Appletea404/Solar_Master_Slave/README.md

# ☀️ HELIOS-BMS

## **1. Project Summary (프로젝트 요약)**

**광원 추적형 태양광 충전 및 다중 센서 안전 제어를 통합한 차세대 EV 플랫폼**

자동차 산업의 전동화 및 SDV(Software Defined Vehicle) 전환 흐름에 대응하여, **태양광 에너지 수집, 고효율 충전 시스템, 배터리 안전 관리, 차량 주행 제어** 기능을 단일 MCU 플랫폼으로 제작

## 2. Key Features (주요 기능)

### 🔋 Buck Converter 기반 태양광 충전 시스템

- **Buck Converter 기반 전용 충전 모듈** 설계로 태양광 전력을 배터리 충전 전압으로 변환
- 태양전지–배터리 결합 시스템의 비선형 동특성을 반영한 **4차 소신호 모델링** 수행
- **MPPT–CC–CV 통합 충전 제어** 구조로 입력 조건과 배터리 상태에 따른 자동 모드 전환
- **PI 제어기 이중 루프 구조** : 전류 루프 1.5 kHz 교차 / 전압 루프 1 Hz 교차로 루프 간 간섭 방지
- 비선형 시뮬레이션 및 실제 STM32 구현을 통해 **평균 약 81~82 % 효율** 달성 (상용 MPPT 모듈 약 78 % 대비 향상)

### 🛡️ 다중 센서 기반 배터리 안전 관리 시스템 (BMS)

- **온도(NTC Thermistor)·가스(MQ-135)·전압·전류(INA219, I2C)** 4종 센서 기반 실시간 계측
- 기존 BMS 의 한계인 **열폭주 초기 오프개싱(Off-gassing) 현상** 을 가스 센서로 조기 감지
- 센서별 **SAFE / WARNING / DANGER** 3단계 상태 분류 및 Electrical 그룹 통합 판단
- WARNING 개수에 따른 **단계적 속도 제한 (80 % → 60 % → 40 % → 0 %)** 및 ramp 방식 점진 반영
- **DANGER latch 구조** 를 통한 이상 원인 기록 및 UART DMA 기반 1초 주기 로그 출력

### 🚗 차량 주행 제어 시스템 (Manual / Auto)

- **수동 주행 모드** : Bluetooth(HC-05) + STM32F411 Blackpill 조이스틱 기반 1바이트 ASCII 명령 제어
- **자율 주행 모드** : 3채널 HC-SR04 초음파 센서 + 4-state FSM(SCAN / PIVOT / BACK / STOP)
- TIM3 입력 캡처를 이용한 ECHO 펄스 측정 및 거리 환산 ($Distance = EchoPulse / 58$)
- **L298N 모터 드라이버** 기반 PWM 속도 제어 및 좌·우 센서 거리 비교를 통한 회피 방향 결정

### 📡 CAN 통신 기반 분산 제어

- **Master Board ↔ Slave Board** 간 CAN 통신을 통한 기능 분산
- **MCP2515 + TJA1050** 구성, 8 MHz 크리스탈 기준 **125 kbps** 비트레이트
- 비트 타이밍 세그먼트(Sync / Prop / Phase1 / Phase2 = 1 / 3 / 8 / 4 Tq) 설계 및 **샘플 포인트 75 %** 적용

### ☀️ 광원 추적 시스템 (Solar Tracking)

- **4채널 CDS 조도 센서** 의 상대 비교 방식 기반 태양 방향 추정
- 좌우 센서 차이(`error_x`)로 **Pan**, 상하 센서 차이(`error_y`)로 **Tilt** 결정
- **Pan/Tilt 2축 서보 모터(MG996R)** 와 PWM 제어를 통한 패널 각도 실시간 추적
- 센서 출력단에 **저역통과 필터(LPF, fc ≒ 15.9 Hz)** 와 **OP-AMP 버퍼(LM358N)** 적용으로 노이즈 제거 및 임피던스 매칭

---

## 🛠 3. Tech Stack (기술 스택)

### 3.1 Language (사용 언어)



### 3.2 Development Environment (개발 환경)

| **STM32CubeIDE** | **STM32CubeMX** |
| :---: | :---: |
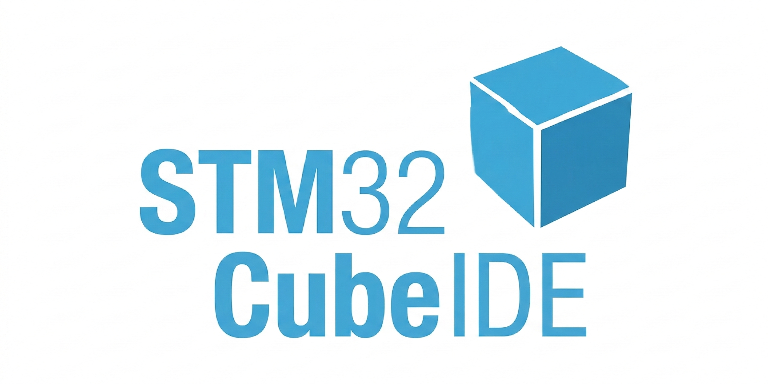
[picture p1: images/stm32cubeide.png]
STM32CubeIDE
|  | STM32CubeMX |
| IDE | Configuration |

### 3.3 Simulation & Analysis (제어 해석 및 시뮬레이션)

| **Google Colab** | **Falstad Circuit Simulator** |
| :---: | :---: |
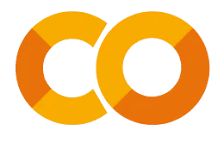
[picture p2: images/Colab.png]
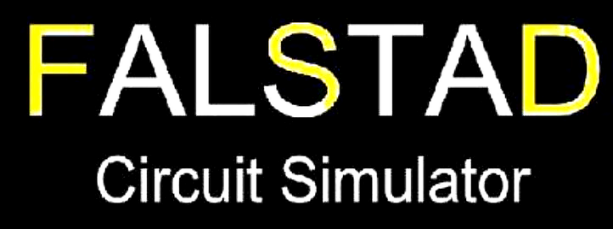
[picture p3: images/Falstad.png]
|  |  |
| 4차 소신호 모델 / Bode Plot 분석 | Buck Converter 회로 동작 검증 |

### 3.4 Debugging Tools (실험 및 디버깅 환경)

| **Moserial** | **Serial Bluetooth Terminal** |
| :---: | :---: |
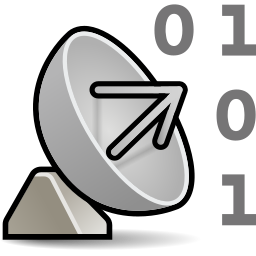
[picture p4: images/Moserial.png]
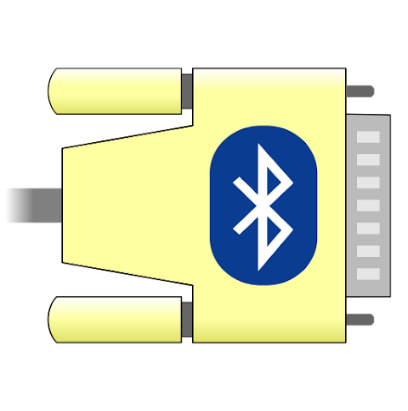
[picture p5: images/Serial_Bluetooth_Terminal.png]
|  |  |
| UART 로그 모니터링 | Bluetooth 기반 명령 송수신 테스트 |

### 3.5 Collaboration Tools (협업 도구)



---

## 📂 4. Project Structure (프로젝트 구조)

### 4.1 Project Tree (프로젝트 트리)

```
HELIOS_BMS/
├── Solar_master_R01/                # Master Board 펌웨어 (차량 제어 + BMS)
│   ├── Core/
│   │   ├── Inc/                     # 헤더 파일 (.h)
│   │   └── Src/
│   │       ├── main.c               # 시스템 초기화 및 메인 루프
│   │       ├── app_bms.c            # BMS 통합 태스크 (App_Bms_Task)
│   │       ├── bms_sensor.c         # INA219 / NTC / MQ-135 센서 측정
│   │       ├── bms_safety.c         # SAFE / WARNING / DANGER 상태 판단
│   │       ├── safe_drive.c         # 단계적 속도 제한 (ramp 적용)
│   │       ├── car_drive.c          # Manual / Auto 주행 FSM
│   │       ├── ultrasonic.c         # HC-SR04 거리 측정 (TIM3 입력 캡처)
│   │       ├── can_master.c         # MCP2515 CAN 송수신 (SPI 기반)
│   │       └── uart_log.c           # UART6 DMA 기반 로그 출력
│   └── Solar_master_R01.ioc         # STM32CubeMX 설정 파일
│
├── Solar_slave_R01/                 # Slave Board 펌웨어 (태양광 + 충전)
│   ├── Core/
│   │   ├── Inc/
│   │   └── Src/
│   │       ├── main.c               # 시스템 초기화 및 메인 루프
│   │       ├── solar_tracking.c     # 4채널 CDS 기반 Pan/Tilt 제어
│   │       ├── servo_pwm.c          # MG996R 서보 PWM 출력
│   │       ├── buck_charger.c       # MPPT-CC-CV 통합 충전 제어
│   │       ├── pi_controller.c      # 전류·전압 이중 루프 PI 제어기
│   │       ├── adc_sensing.c        # 입출력 전압·전류 ADC 계측
│   │       └── can_slave.c          # MCP2515 CAN 수신
│   └── Solar_slave_R01.ioc          # STM32CubeMX 설정 파일
│
├── Remote/                          # 원격 조종기 (STM32F411 Blackpill)
│   └── Core/
│       └── Src/
│           └── main.c               # 조이스틱 ADC + 푸쉬버튼 입력
│
├── 공모전파일/                        # 공모전 제출 자료 (보고서, 사진, BOM)
│
├── .gitignore                       # Git 제외 항목 설정
└── README.md                        # 프로젝트 개요 문서
```

### 4.2 Hardware Block Diagram (전체 하드웨어 블록도)

HW Diagram

| **Master Board** | **Slave Board** |
| :---: | :---: |
| 차량 주행 제어 + 배터리 안전 관리 | 광원 추적 + 태양광 충전 |
| HC-05 / 조이스틱 명령 수신 | 4채널 CDS + 서보 Pan/Tilt 제어 |
| 다중 센서 기반 BMS 판단 | Buck Converter + MPPT-CC-CV |
| L298N 모터 드라이버 PWM 제어 | 입출력 전압·전류 ADC 계측 |

### 4.3 Master Board FSM

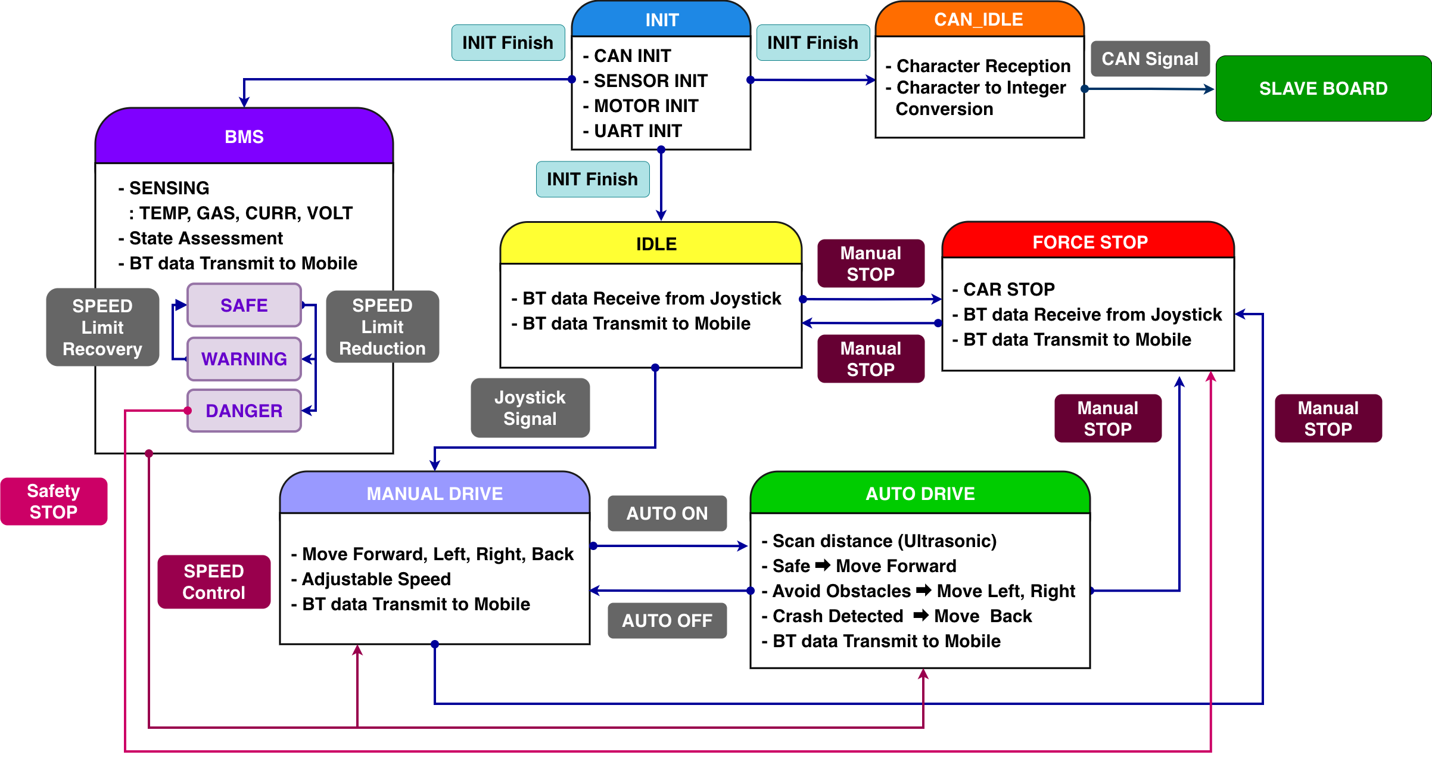
[picture p6: images/Master Board FSM.png]
MasterBoard


### 4.4 Slave Board FSM

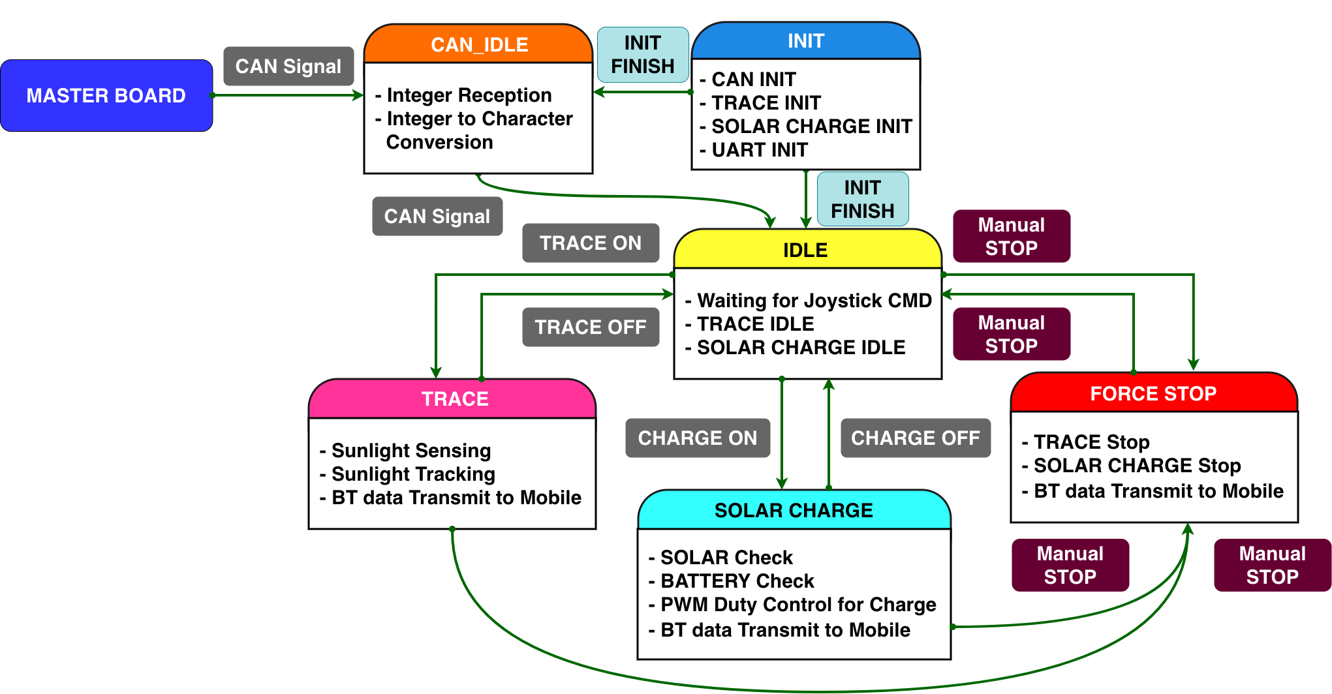
[picture p7: images/Slave Board FSM.png]
SlaveBoard


---

## 🧮 5. Control Theory & Implementation (제어 이론 및 구현)

### 5.1 4차 소신호 모델링 (4th-order Small-signal Modeling)

태양전지–배터리 결합 시스템은 입력(태양전지의 비선형 I-V 특성)과 출력(배터리 CC-CV 특성)이 동시에 변하는 비선형 시스템이다. 단순 Buck Converter 모델로는 이러한 동특성을 정확히 반영할 수 없으므로, 입력과 출력의 결합 특성을 고려한 **4차 소신호 모델** 을 구성하였다.

**상태 변수 정의:**

$$x = [v_{pv}, \ v_{in}, \ i_L, \ v_o]^T$$

| 상태 변수 | 의미 |
| :---: | :--- |
| $v_{pv}$ | 태양전지 전압 |
| $v_{in}$ | 스위칭 입력 전압 |
| $i_L$ | 인덕터 전류 |
| $v_o$ | 출력 전압 |

입력단을 $v_{pv}$ 와 $v_{in}$ 으로 분리하여 태양전지의 비선형 특성과 스위칭 동작이 결합된 입력 동특성을 반영

### 5.2 MPPT–CC–CV 통합 충전 제어

전류 지령은 **CC, CV, MPPT 조건 중 가장 작은 값** 으로 결정되며, 입력 조건과 배터리 상태에 따라 충전 모드가 자동 전환

$$i_{ref} = \min(I_{CC}, \ I_{CV}, \ I_{MPPT})$$

### 5.3 PI 제어기 설계 결과

| **구분** | **fc** | **fz** | **Kp** | **Ki** | **PM** |
| :---: | :---: | :---: | :---: | :---: | :---: |
| **전류 루프** | 1500 Hz | 300 Hz | 0.457 | 861.9 | 63.1° |
| **전압 루프** | 1 Hz | 0.2 Hz | 6.54 | 8.21 | 168.6° |

전류 루프는 내부 루프로서 빠른 전류 추종을 위해 높은 대역폭을 가지며, 전압 루프는 외부 루프로서 충분히 느리게 동작하도록 설계하여 **루프 간 간섭을 방지** 

### 5.4 BMS 안전 상태 판단 기준

| **센싱 데이터** | **상태** | **기준** |
| :---: | :---: | :---: |
| **TEMP** | SAFE | < 45 ℃ |
| | WARNING | ≥ 45 ℃ |
| | DANGER | ≥ 55 ℃ |
| **GAS** | SAFE | ΔADC < 150 |
| | WARNING | ΔADC ≥ 150 |
| | DANGER | ΔADC ≥ 400 |
| **CURRENT** | SAFE | < 1700 mA |
| | WARNING | ≥ 1700 mA |
| | DANGER | ≥ 2500 mA |
| **VOLTAGE** | UNDER WARNING | ≤ 8.0 V |
| | UNDER DANGER | ≤ 5.0 V |
| | OVER WARNING | ≥ 13.0 V |
| | OVER DANGER | ≥ 13.5 V |

#### 5.4.1 단계적 속도 제한 정책

| **시스템 상태** | **최대 속도 제한** |
| :---: | :---: |
| SAFE | 80 % |
| WARNING 1개 | 60 % |
| WARNING 2개 | 40 % |
| WARNING 3개 또는 DANGER | 0 % (차량 정지) |

속도 제한 값은 **400 ms 주기로 갱신** 되며 **ramp 방식으로 점진적으로 반영**

### 5.6 수동 주행 명령 (Remote Command Map)

| **명령 코드** | **동작** | **속도** |
| :---: | :---: | :---: |
| 'F' | 전진 | 100 % |
| 'Q' | 전진 (저속) | 50 % |
| 'B' | 후진 | 100 % |
| 'W' | 후진 (저속) | 50 % |
| 'L' | 좌 회전 | 100 % |
| 'E' | 좌 회전 (저속) | 50 % |
| 'R' | 우 회전 | 100 % |
| 'T' | 우 회전 (저속) | 50 % |
| 'S' | 정지 | 0 % |
| 'A' | 자율 / 수동 모드 전환 | - |
| 'P' | 강제 정지 / 재초기화 토글 | - |

### 5.7 CAN 통신 구성

#### 5.7.1 하드웨어 구성

| **항목** | **구성** |
| :---: | :--- |
| CAN 컨트롤러 | MCP2515 |
| CAN 트랜시버 | TJA1050 |
| 인터페이스 | SPI1 (CS: PB12, INT: PC7) |
| 클럭 | 8 MHz 크리스탈 |
| 비트레이트 | 125 kbps |

#### 5.7.2 비트 타이밍 설계

CAN 은 비동기 통신이므로 노드 간 동기화를 위해 정확한 비트 타이밍 설정이 요구된다. 하나의 비트 시간 $T_{Bit}$ 은 아래 4개 세그먼트의 합으로 구성된다.

$$T_{Bit} = T_{Sync} + T_{Prop} + T_{Phase1} + T_{Phase2}$$

8 MHz 크리스탈 기준 125 kbps 를 목표 비트레이트로 설정하면 한 비트 시간은 $8\ \mu s$ 이다. BRP=1 로 설정 시 Time Quantum 은 $T_q = 0.5\ \mu s$ 이므로 한 비트당 **16 Tq** 가 필요하다.

| **세그먼트** | **설정값** | **길이** |
| :---: | :---: | :---: |
| Sync_Seg | 고정 | 1 Tq |
| Prop_Seg | PRSEG = 2 | 3 Tq |
| Phase_Seg1 | PHSEG1 = 7 | 8 Tq |
| Phase_Seg2 | PHSEG2 = 3 | 4 Tq |
| **합계** | | **16 Tq** |

샘플 포인트는 비트 시간의 **75 %** 지점으로 설정하여 버스 신호가 안정된 영역에서 샘플링을 수행한다.

$$Sample\ Point = \frac{T_{Sync} + T_{Prop} + T_{Phase1}}{T_{Bit}} = \frac{1 + 3 + 8}{16} = 75\ \%$$

MCP2515 의 비트 타이밍 레지스터 설정값은 다음과 같다.

| **레지스터** | **값** | **설명** |
| :---: | :---: | :--- |
| CNF1 | `0x01` | BRP = 1 |
| CNF2 | `0xBA` | PHSEG1 = 7, PRSEG = 2, BTLMODE = 1 |
| CNF3 | `0x03` | PHSEG2 = 3 |

#### 5.7.3 애플리케이션 프로토콜

데이터 필드는 **CMD(1 Byte) + VALUE(1 Byte)** 의 2바이트 구조로 정의된다.

| **CMD** | **CMD 코드** | **VALUE** | **동작** |
| :---: | :---: | :---: | :--- |
| TRACE_CTRL | `0x10` | `0x01` / `0x00` | 광원 추적 ON / OFF |
| SOLAR_CTRL | `0x11` | `0x01` / `0x00` | 태양광 충전 ON / OFF |
| FORCE_CTRL | `0x12` | `0x01` / `0x02` | 강제 정지 / 재초기화 |
| DRIVE_CTRL | `0x13` | `0x01` / `0x00` | 자율주행 ON / OFF |

### 5.8 광원 추적 시스템 (Solar Tracking System)

#### 5.8.1 센서 배치 및 회로 구성

광원 추적 시스템은 **4채널 CDS 조도 센서** 의 상대 비교 방식으로 태양의 방향을 추정한다. 센서는 패널 상·하·좌·우 4개 위치에 배치되며, 각 센서의 조도 차이가 서보 모터의 회전 방향을 결정한다.

| **채널** | **ADC CH** | **MCU 핀** | **위치** |
| :---: | :---: | :---: | :---: |
| S1 | CH4 | PA4 | 우상 (Right-Top) |
| S2 | CH8 | PB0 | 우하 (Right-Bottom) |
| S3 | CH10 | PC0 | 좌상 (Left-Top) |
| S4 | CH11 | PC1 | 좌하 (Left-Bottom) |

각 센서는 **10 kΩ 고정 저항과 CDS 센서의 풀업 전압 분배 회로** 로 구성되며, 조도에 따라 변하는 CDS 저항값이 출력 전압으로 변환된다.

$$V_{out} = V_{cc} \times \frac{R_{fixed}}{R_{fixed} + R_{CDS}}$$

신호 안정성 확보를 위해 **저역통과 필터(LPF, $f_c \approx 15.9\ Hz$)** 와 **LM358N OP-AMP 전압 버퍼($A_v = 1$)** 를 적용하여 고주파 노이즈 제거 및 임피던스 매칭을 수행한다. 이후 **ADC1 12비트 연속 변환(DMA)** 으로 4채널을 순차 샘플링하여 `adcValue[4]` 배열에 저장한다.

$$V_{ADC} = \frac{ADC_{raw}}{4096} \times V_{ref}$$

#### 5.8.2 태양 방향 추정 (error_x / error_y)

필터링된 4채널 값으로 좌우(`error_x`) 와 상하(`error_y`) 오차를 각각 계산한다.

$$error\_x = (S3 + S4) - (S1 + S2) \quad \text{(좌측 합 - 우측 합)}$$

$$error\_y = (S1 + S3) - (S2 + S4) \quad \text{(상측 합 - 하측 합)}$$

| **오차 부호** | **의미** | **서보 동작** |
| :---: | :---: | :---: |
| $error\_x > +800$ | 좌측이 더 밝음 | Pan 감소 (← 좌 회전) |
| $error\_x < -800$ | 우측이 더 밝음 | Pan 증가 (→ 우 회전) |
| $error\_y > +800$ | 상측이 더 밝음 | Tilt 증가 (↑ 상 회전) |
| $error\_y < -800$ | 하측이 더 밝음 | Tilt 감소 (↓ 하 회전) |

임계값 **THRESHOLD = 800** 은 **Dead Zone** 로 작용하여 미세 진동에 의한 불필요한 서보 진동(Jitter)을 방지한다.

---

## 🏁 6. Final Product & Demonstration (완성품 및 시연)

### 6.1 Final Product (완성품)

### 6.2 하드웨어 제작 및 조립

| **리모컨 제작 (전면 & 후면부)** | **감지 모듈 PCB 제작 (상부 & 하부 사진)** |
| :---: | :---: |
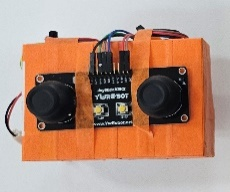
[picture p8: images/1.jpg]
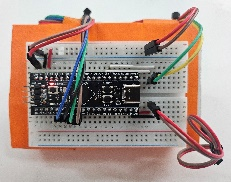
[picture p9: images/2.jpg]
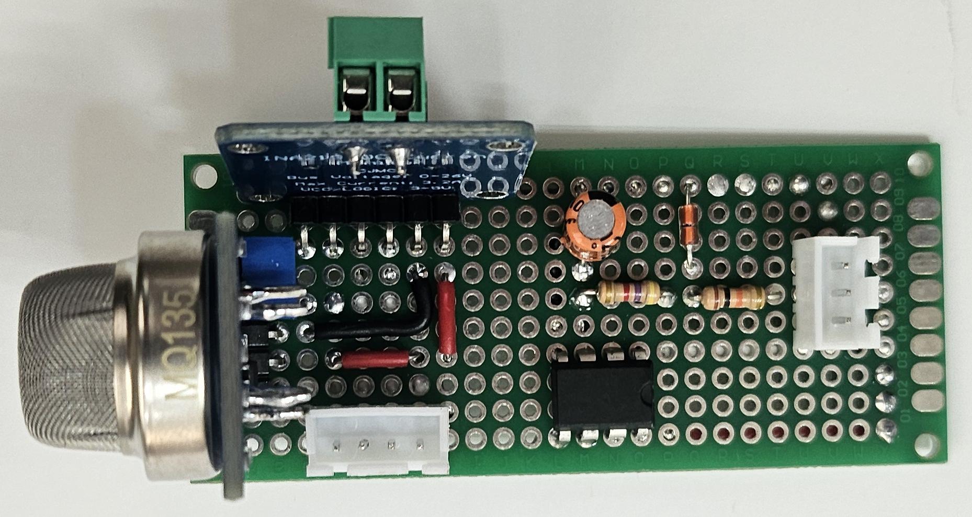
[picture p10: images/3.jpg]
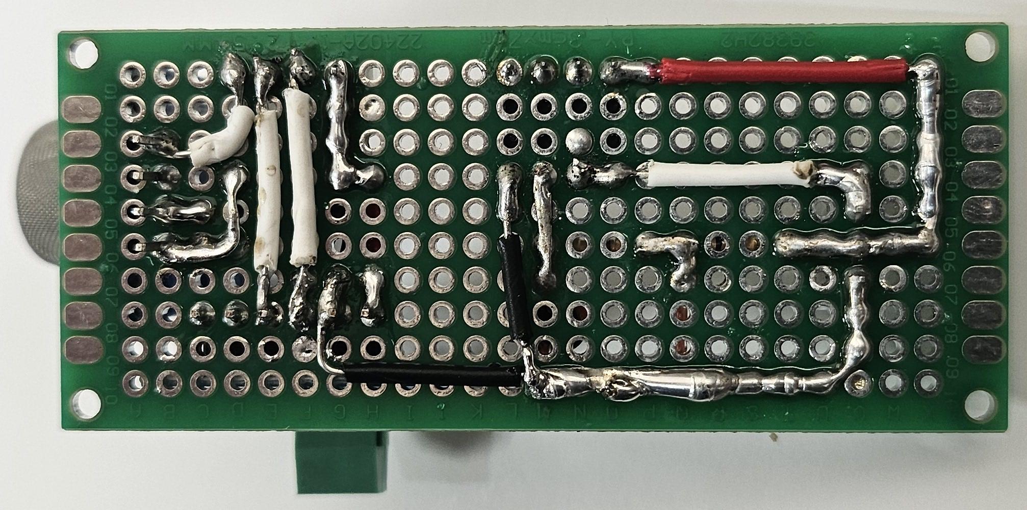
[picture p11: images/4.jpg]
| &nbsp; | &nbsp; | 
| **광원 추적 시스템** | **Buck Converter 기반 배터리 충전 시스템** |
| **(1) 구동 파트 제작 (상부 & 하부 사진)** | **(1) 구동 파트 제작 (좌측 & 우측 사진)** |
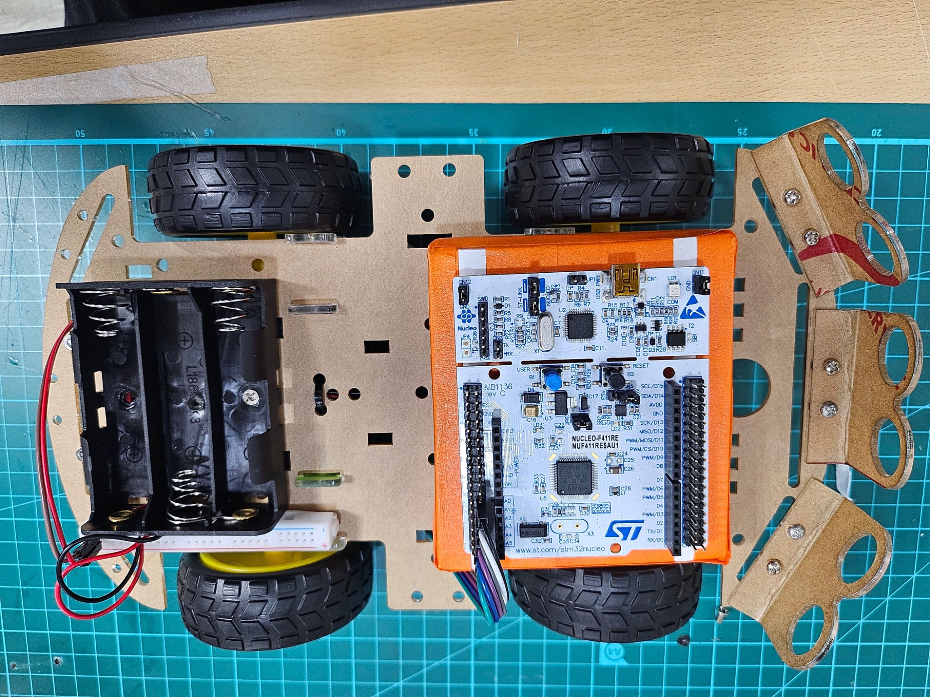
[picture p12: images/5.jpg]
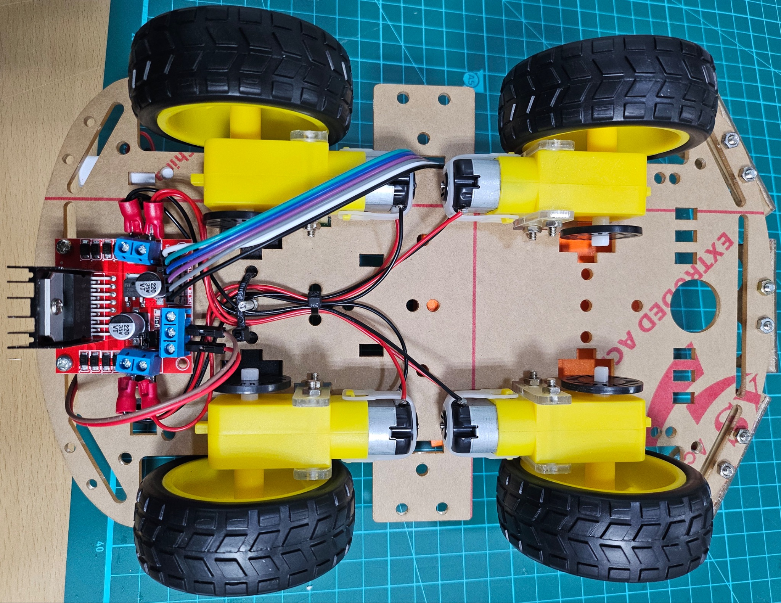
[picture p13: images/6.jpg]
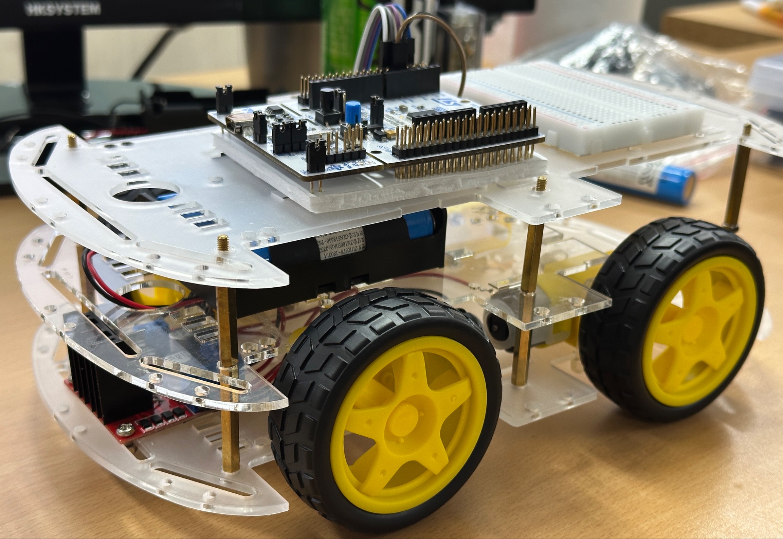
[picture p14: images/7.jpg]
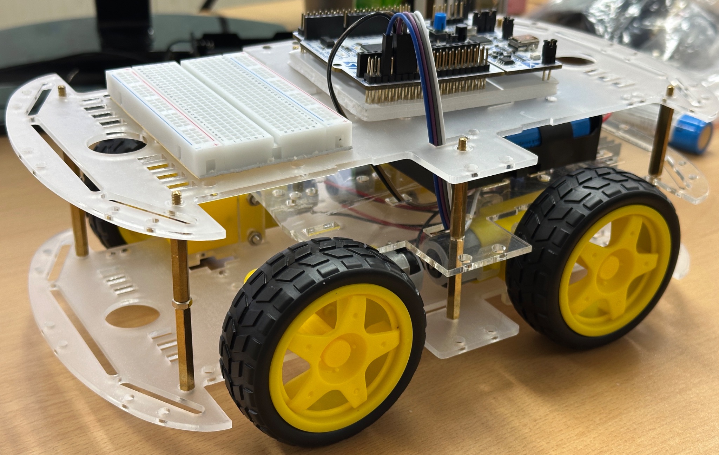
[picture p15: images/8.jpg]
| &nbsp; | &nbsp; |
| **(2) 광원 추적 모듈 제작 (회로 기판 & 회전 장치 사진)** | **(2) 배터리 충전 모듈 제작** |
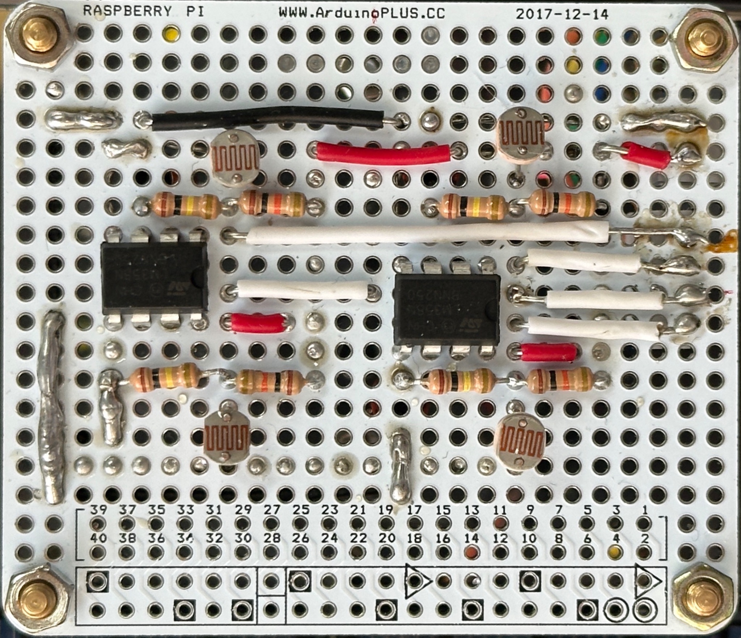
[picture p16: images/9.jpg]
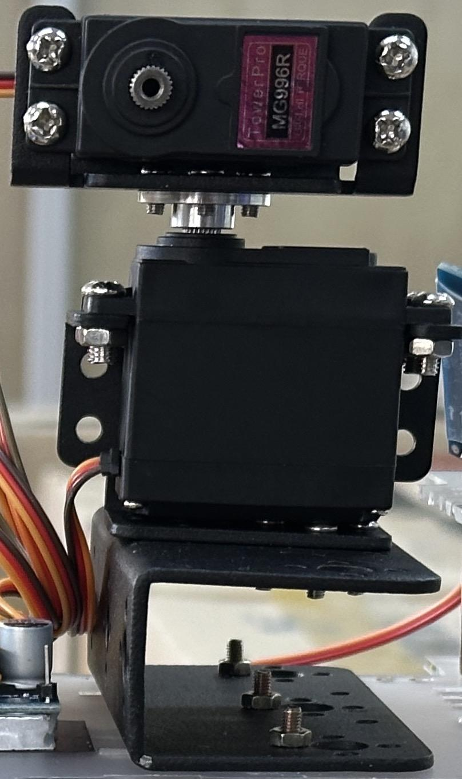
[picture p17: images/10.jpg]
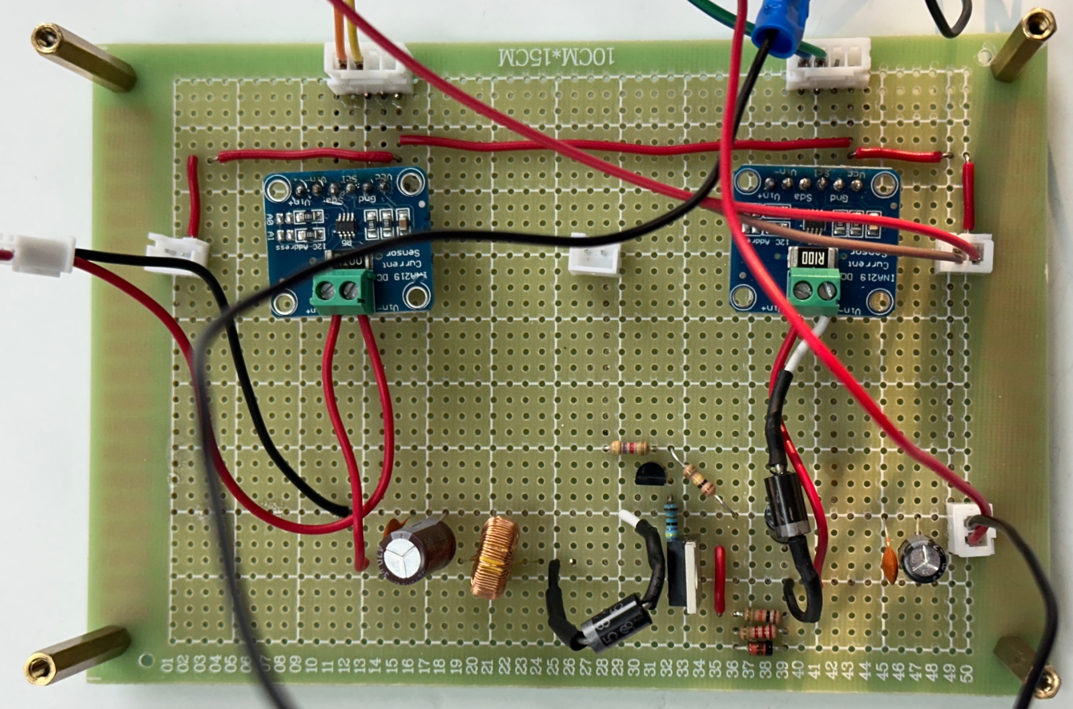
[picture p18: images/11.jpg]
| &nbsp; |  |
| **(3) 동작 구현 (좌측 & 우측 사진)** | **(3) 동작 구현 (좌측 & 우측 사진)** |
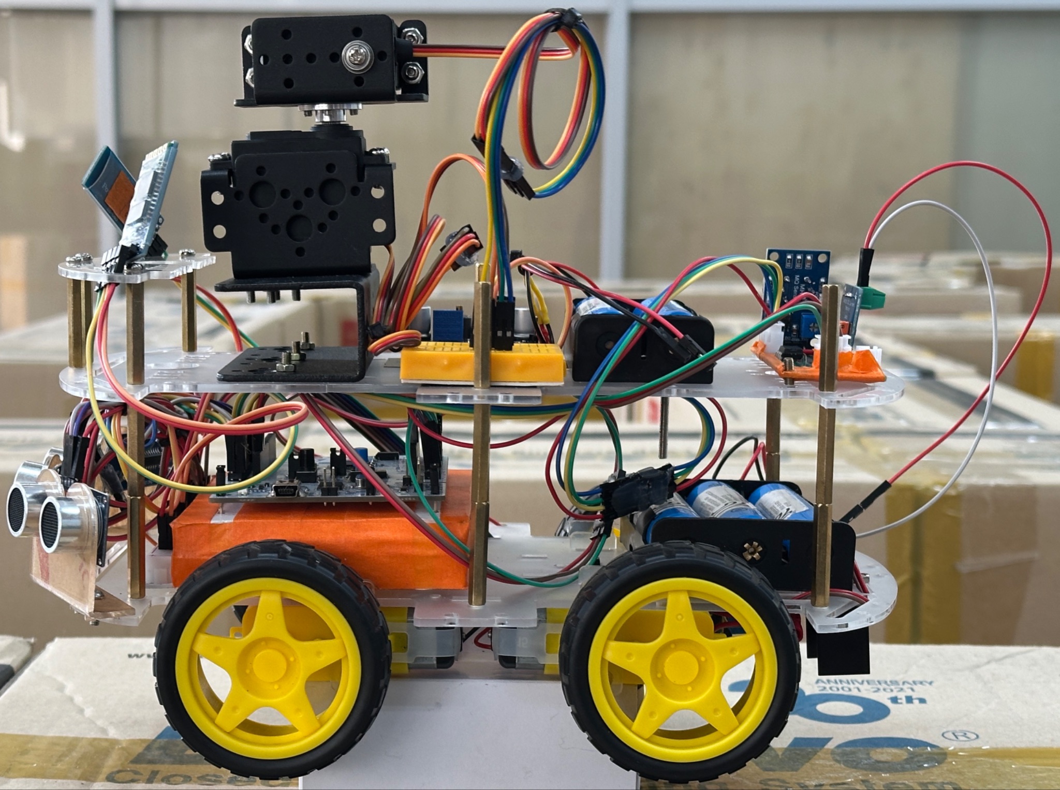
[picture p19: images/12.jpg]
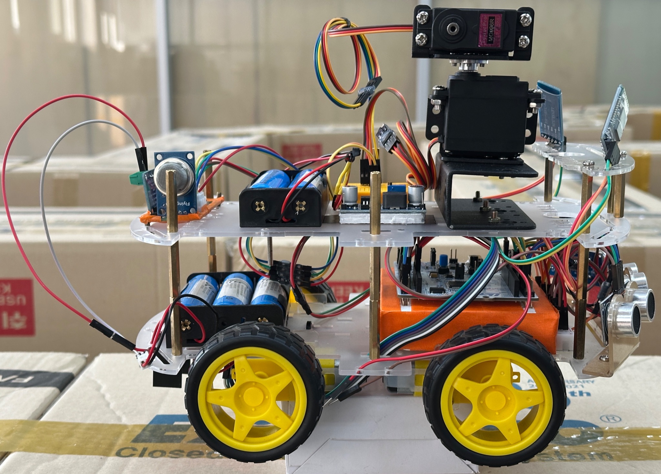
[picture p20: images/13.jpg]
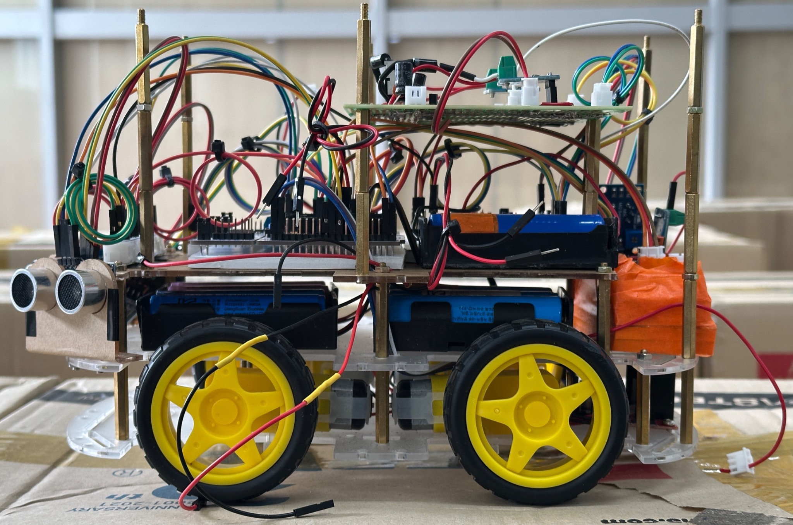
[picture p21: images/14.jpg]
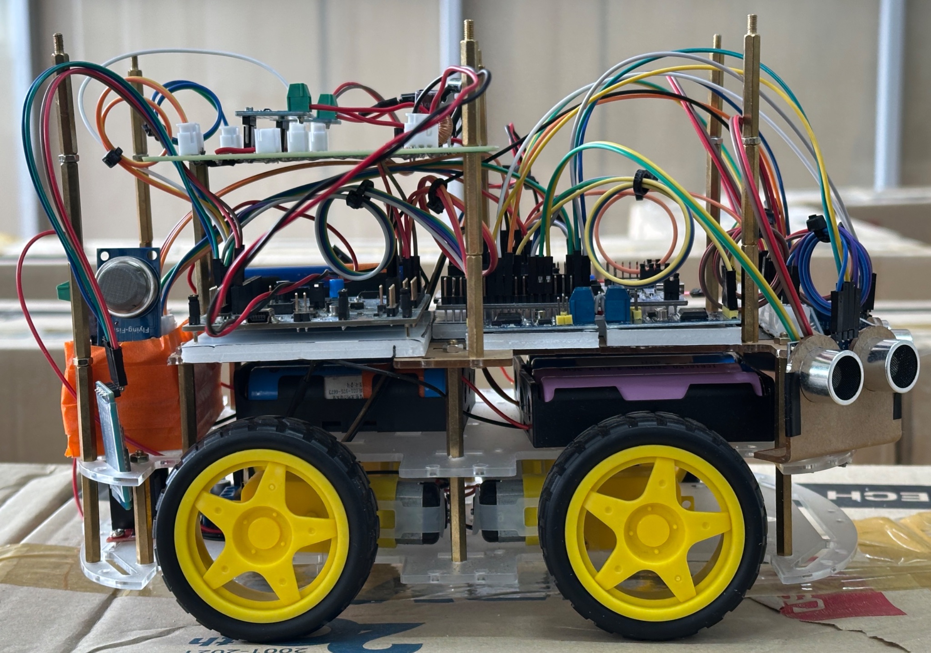
[picture p22: images/15.jpg]
| &nbsp; | &nbsp; |
| **(4) 최종 시스템 구현 (전면 & 후면 사진)** | **(4) 최종 시스템 구현 (좌측 & 우측 사진)** |
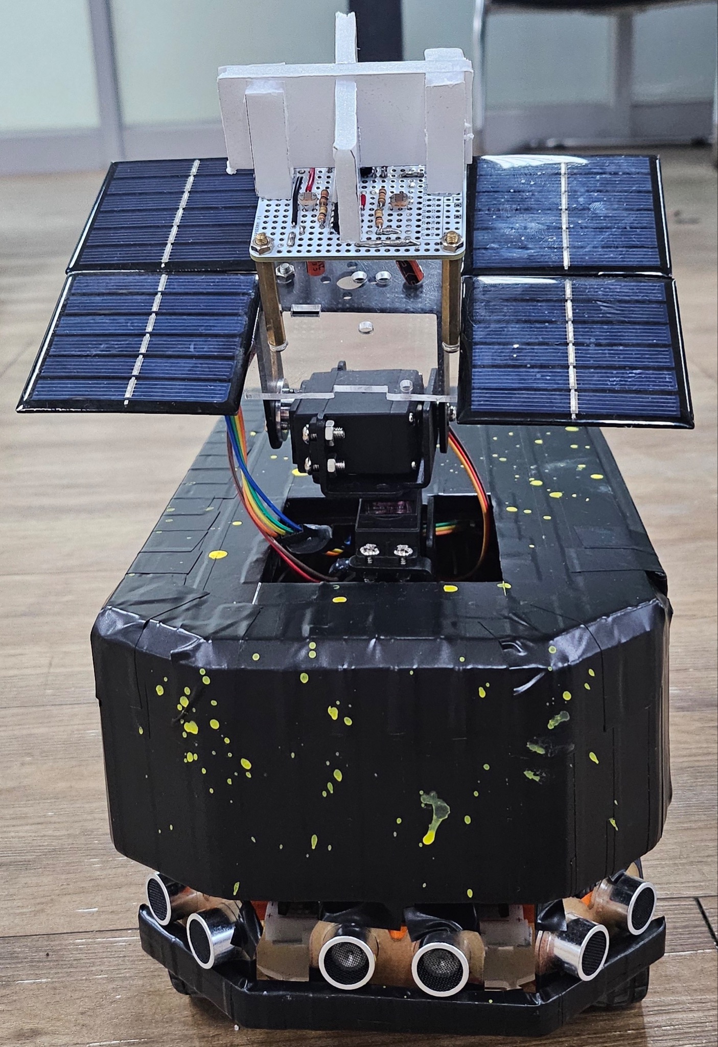
[picture p23: images/16.jpg]
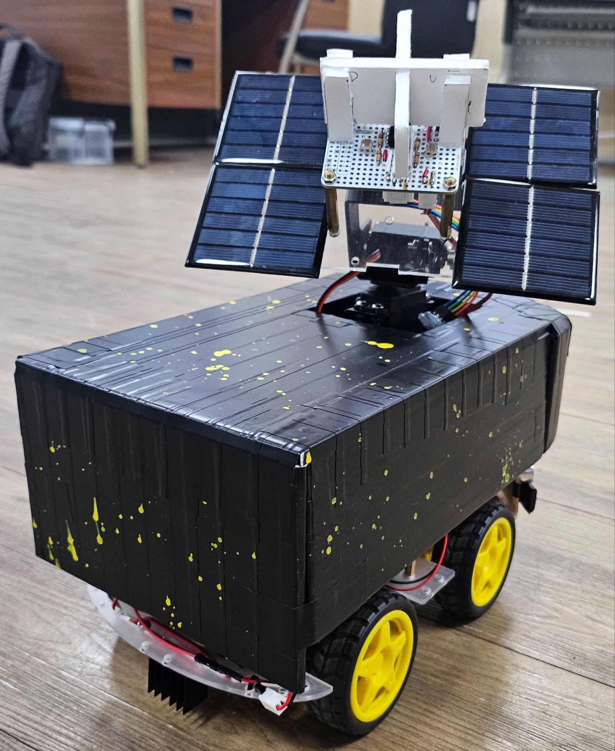
[picture p24: images/17.jpg]
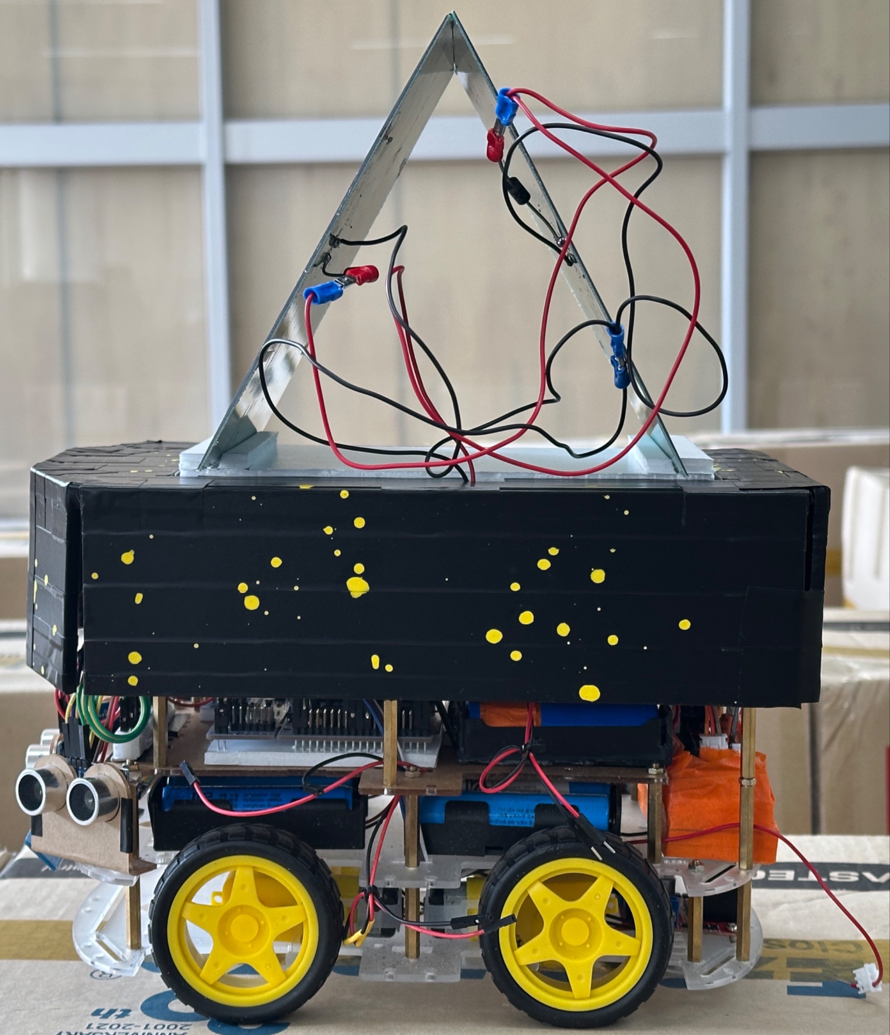
[picture p25: images/18.jpg]
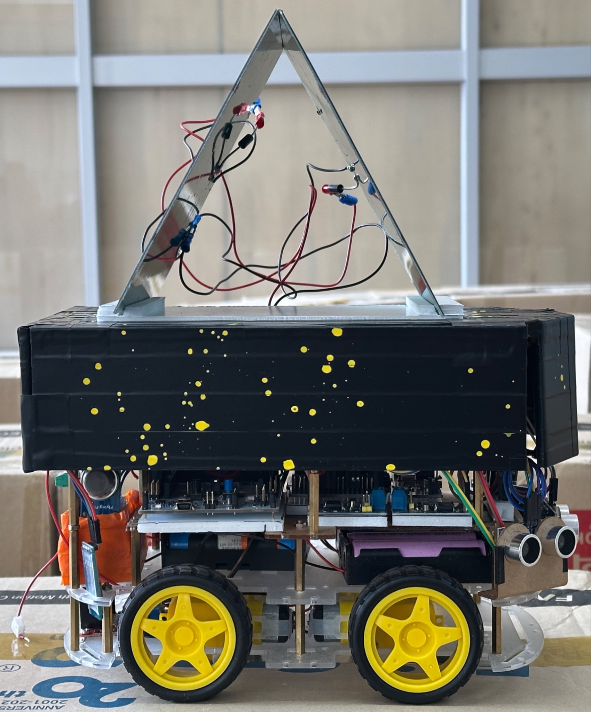
[picture p26: images/19.jpg]
| &nbsp; | &nbsp; |

### 6.3 Demonstration (시연 영상)

<a href="https://www.youtube.com/playlist?list=PL6xfXHA4BYR9Hl2bLpyACR_jpAFE2U8kd" target="_blank">
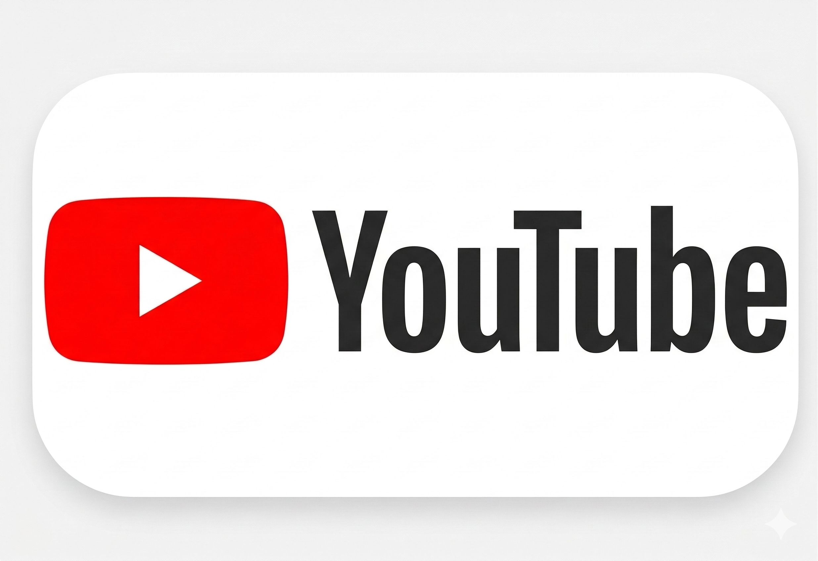
[picture p27: images/youtube.jpg]
Watch Demo Video
  
</a>

**Demonstration Check List:**

| **항목** | **검증 내용** |
| :---: | :--- |
| **01. Temp Stress Test** | 고온 환경에서의 온도 센서 응답 및 속도 제한 동작 검증 |
| **02. Gas Stress Test** | MQ-135 센서 baseline 대비 가스 농도 변화 감지 검증 |
| **03. Electrical Stress Test** | INA219 기반 과전류 / 과전압 / 저전압 보호 동작 검증 |
| **04. BMS Stress Test** | 다중 WARNING 발생 시 단계적 속도 제한 및 latch 구조 검증 |
| **05. Solar Charge System Simulation** | CC → MPPT → CV 모드 전환 및 충전 효율 검증 |
| **06. Solar Trace Simulation** | 4채널 CDS 센서 기반 Pan/Tilt 추적 동작 검증 |

---

## 7. Troubleshooting (문제 해결 기록)

소신호 모델링 2차항에서 4차항

ina219 인덕터 i2c 노이즈 문제

태양광 cc cv 전환이 잘 안됨

회로기판 납땜시 부족

자율주행 오류

태양광 추적시스템 작동 오류

### 7.1 소신호모델링 항수부족

🔍 **Issue (문제 상황)**

- PID제어를 위한 K상수값을 구하는데 실제 계산과 오차가 생김

❓ **Analysis (원인 분석)**

- 전압센서인 Ina219의 측정방식이 Vin Vout의 차이를 통해 전압값을 계산함 
- 

❗ **Action (해결 방법)**

- 입력단을 $v_{pv}$ 와 $v_{in}$ 으로 분리한 **4차 소신호 모델** 구성
- SW ON / SW OFF 상태별 미분방정식 도출 후 듀티비 $d$ 를 이용한 **평균화 비선형 모델** 유도
- 정상상태 동작점 주변 선형화를 통해 상태공간 행렬 $A$, $B$ 도출 및 PI 제어기 설계

✅ **Result (결과)**

- Bode Plot 분석을 통해 전류 루프 PM 63.1°, 전압 루프 PM 168.6° 의 안정적인 위상 여유 확보
- 비선형 시뮬레이션에서 약 0.8 A 로 안정적 수렴 및 모드 전환 정상 동작 확인

### 7.2 I2C 노이즈 간섭

🔍 **Issue (문제 상황)**

- Ina219를 통한 I2C 통신이 불안정하여 센서 초기화가 실행 되지 않는 오류가 있음

❓ **Analysis (원인 분석)**

- Ina219는 I2C를 이용하여 데이터를 보내는데 이는 노이즈에 민감함
- 벅컨버터의 인덕터가 자기 노이즈를 발생시키는데 이것이 Ina219 I2C선과 가까워서 간섭이 있는걸로 생각함

❗ **Action (해결 방법)**

- Ina219와 인덕터의 거리를 멀리 떨어뜨려놓아서 인덕터의 노이즈 간섭이 없게함

✅ **Result (결과)**

- Ina219 센서가 초기화가 안되는 오류는 없어짐

---

### 7.3 태양광 충전시 CC, CV문제

🔍 **Issue (문제 상황)**

- 충전 진행 중 입력 조건(일사량) 변화와 배터리 상태 변화가 동시에 발생할 때, MPPT / CC / CV 모드 간 전환이 매끄럽지 않고 진동 발생

❓ **Analysis (원인 분석)**

- 각 모드가 독립적으로 전류 지령을 생성하는 경우 모드 경계에서 지령 값이 충돌하여 진동 유발
- 단순 우선순위 기반 모드 선택은 입력·배터리 조건이 동시에 변할 때 부드러운 전환을 보장하지 못함

❗ **Action (해결 방법)**

- 전류 지령을 **min 함수 기반 통합 구조** 로 재설계: $i_{ref} = \min(I_{CC}, I_{CV}, I_{MPPT})$
- 가장 작은 전류 지령이 항상 지배하도록 하여 모드 전환을 자동·연속적으로 수행

✅ **Result (결과)**

- 약 3.7 V 배터리 조건 실험에서 CC → MPPT → CC → CV 모드 전환이 끊김 없이 수행됨을 확인
- **평균 충전 효율 약 81~82 %** 달성 (상용 MPPT 모듈 약 78 % 대비 향상)

---

### 7.3 기존 BMS 의 열폭주 조기 감지 한계

🔍 **Issue (문제 상황)**

- 전압·전류·온도 중심의 기존 BMS 구조로는 배터리 열폭주(Thermal Runaway) 의 초기 단계인 **오프개싱(Off-gassing) 현상** 을 사전 감지하지 못함
- 인천 청라 전기차 화재 사례와 같이, BMS 이상 경고가 발생하지 않은 상태에서 화재로 진행될 수 있는 위험 존재

❓ **Analysis (원인 분석)**

- 셀 내부에서 가스가 방출되는 단계에서는 외부 온도·전압·전류에 유의미한 변화가 발생하지 않을 수 있음
- 전기적 이상 신호가 나타날 시점에는 이미 열폭주가 본격화된 상태일 가능성이 큼

❗ **Action (해결 방법)**

- 기존 감시 구조에 **MQ-135 가스 센서** 를 추가하여 다중 안전 감지 시스템 구성
- 시스템 시작 시 일정 시간 동안 baseline 평균을 형성하고, 현재 측정값과의 차이($\Delta ADC$) 로 가스 농도 변화 판단
- 노이즈 감소를 위한 **이동 평균 필터** 적용 및 SAFE / WARNING / DANGER 단계별 임계값 정의

✅ **Result (결과)**

- 가스 농도 변화 조기 감지 후 **단계적 속도 제한** (80 % → 60 % → 40 % → 0 %) 적용 가능
- DANGER 발생 원인을 latch 구조에 기록하여 사후 로그 분석 가능

---

### 7.4 조도 센서 출력 노이즈 및 임피던스 매칭 문제

🔍 **Issue (문제 상황)**

- CDS 조도 센서의 ADC 입력 신호에 고주파 노이즈가 섞여 Pan/Tilt 제어 시 서보 떨림(jitter) 발생
- 센서 출력 임피던스가 ADC 입력 임피던스와 맞지 않아 측정값이 불안정

❓ **Analysis (원인 분석)**

- CDS 센서와 10 kΩ 풀업 저항으로 구성된 전압 분배 회로의 출력 임피던스가 높음
- ADC 샘플링 시 입력 캐패시턴스 충전이 충분히 이루어지지 않아 측정 오차 발생
- 외부 EMI 및 전원 노이즈가 신호선에 직접 유입

❗ **Action (해결 방법)**

- **저역통과 필터(LPF)** 추가하여 차단 주파수 $f_c \approx 15.9 \ Hz$ 이상의 노이즈 제거
- **LM358N OP-AMP 를 전압 버퍼($A_v = 1$) 로 구성** 하여 임피던스 매칭 및 위상 유지
- 12비트 ADC 로 정량화하여 정밀 조도 비교 가능하도록 구성

✅ **Result (결과)**

- 4채널 CDS 센서의 안정적인 ADC 측정값 확보
- 좌·우 / 상·하 센서 차이 비교를 통한 부드러운 Pan/Tilt 추적 동작 확인

---

### 7.5 CAN 통신 비트 타이밍 정확도 확보

🔍 **Issue (문제 상황)**

- Master ↔ Slave 간 CAN 통신 초기 구현 시 메시지 손실 및 ACK 미수신 발생
- 비트 타이밍이 부정확하여 노드 간 동기화 실패

❓ **Analysis (원인 분석)**

- MCP2515 의 비트 타이밍 레지스터(CNF1, CNF2, CNF3) 설정값이 8 MHz 크리스탈 기준 125 kbps 목표와 정합되지 않음
- 샘플 포인트가 적절한 위치에 있지 않아 신호 안정 영역에서 샘플링되지 못함

❗ **Action (해결 방법)**

- Time Quantum 기준으로 비트 시간 분할: $T_q = 0.5 \ \mu s$, **Total = 16 Tq**
- 세그먼트 배분: Sync(1) + Prop(3) + Phase1(8) + Phase2(4) = 16 Tq
- **샘플 포인트 75 %** 적용하여 비트 시간의 75 % 지점에서 안정적 샘플링 수행
- MCP2515 가 ACK 미수신 시 자동 재전송하도록 설정 + 소프트웨어 재시도 로직 이중화

✅ **Result (결과)**

- 안정적인 125 kbps CAN 통신 확보
- Master ↔ Slave 간 표준 데이터 프레임(0x123 ID, DLC=2) 기반 명령 송수신 정상 동작

---

## 📦 8. Bill of Materials (주요 부품 리스트)

> 구매처: 디바이스마트 / 상세 BOM 은 `공모전파일/` 디렉토리 참조

### 8.1 태양광 충전 시스템

| 분류 | 부품명 | 비고 |
| :---: | :---: | :---: |
| 태양전지 | D165x165-3 (6 V 4.5 W) | - |
| 전력 소자 | IRF9540N / 1N5822 / 2N2222A | P-MOSFET / Diode / BJT |
| 인덕터 | RING COIL 11파이 (220 µH) | - |
| 캐패시터 | E/C 16 V 220 µF / 50 V 10 µF / 16 V 470 µF | - |
| 전류 센서 | INA219 (SZH-SSBH-075) | I2C |
| 배터리 | UB848 (18650 3.7 V 2600 mAh) | - |

### 8.2 광원 추적 시스템

| 분류 | 부품명 | 비고 |
| :---: | :---: | :---: |
| 서보 모터 | TowerPro MG996R | Pan / Tilt |
| 조도 센서 | CdS Cell GL5549 | 4 채널 |
| 전원 | SRS-155 (3 V 150 mA) | - |
| OP-AMP | LM358N | 전압 버퍼 |
| Buck Module | LM2596HV | - |

### 8.3 배터리 안전 관리 시스템

| 분류 | 부품명 | 비고 |
| :---: | :---: | :---: |
| 온도 센서 | NTC-10KGJG | 10 kΩ Thermistor |
| 가스 센서 | MQ-135 (SZH-SSBH-038) | - |
| 전류 센서 | INA219 (SZH-SSBH-075) | I2C |
| OP-AMP | LM358N | LPF 버퍼 |

### 8.4 차량 주행 제어 시스템

| 분류 | 부품명 | 비고 |
| :---: | :---: | :---: |
| MCU | NUCLEO-F411RE | Master Board |
| 모터 드라이버 | L298N (SZH-EK001) | 2 A |
| 초음파 센서 | HC-SR04 (SZH-USBC-004) | 3 채널 |
| Bluetooth | HC-05 / HC-06 | - |
| CAN 컨트롤러 | MCP2515 + TJA1050 | SPI |

### 8.5 무선 조종부

| 분류 | 부품명 | 비고 |
| :---: | :---: | :---: |
| MCU | STM32F411 BlackPill | Adafruit ada-4877 |
| 조이스틱 | PS2 듀얼 로커 모듈 (ELB070682) | - |
| Bluetooth | HC-05 (SZH-EK069) | - |
