Appletea404/Solar_Master_Slave/공모전파일/2) 그림파일들/그림 1. 한국의 에너지 수입 의존 구조.png

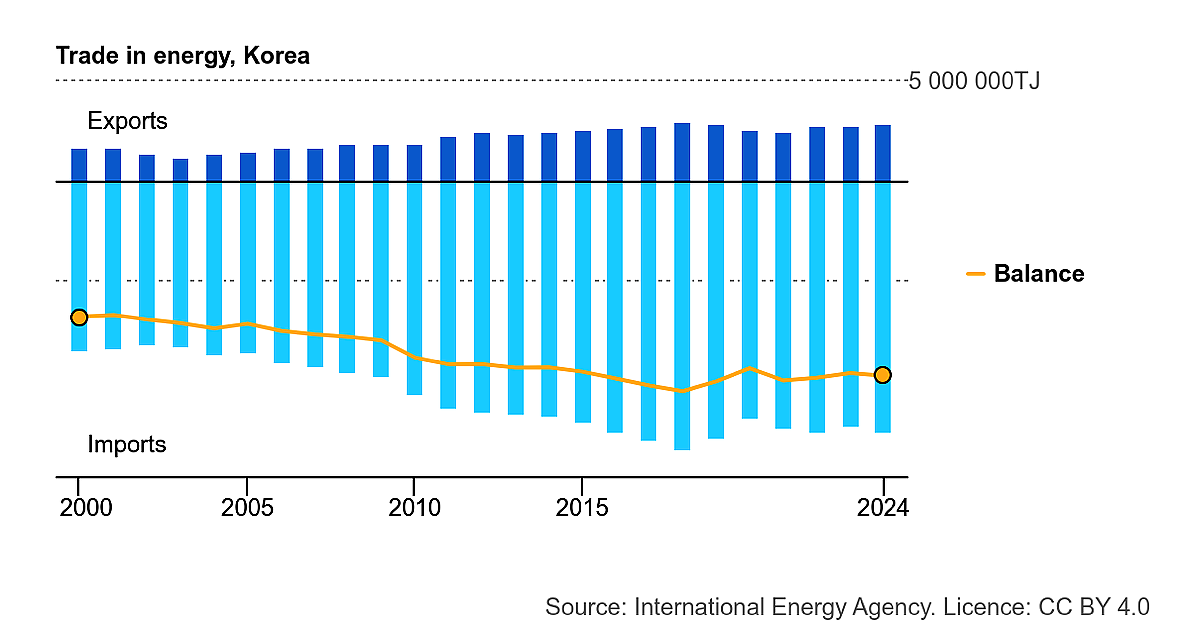
공모전파일/2) 그림파일들/그림 1. 한국의 에너지 수입 의존 구조.png
