Appletea404/Solar_Master_Slave/공모전파일/2) 그림파일들/그림 2. 태양전지의 IV 특성 곡선.png

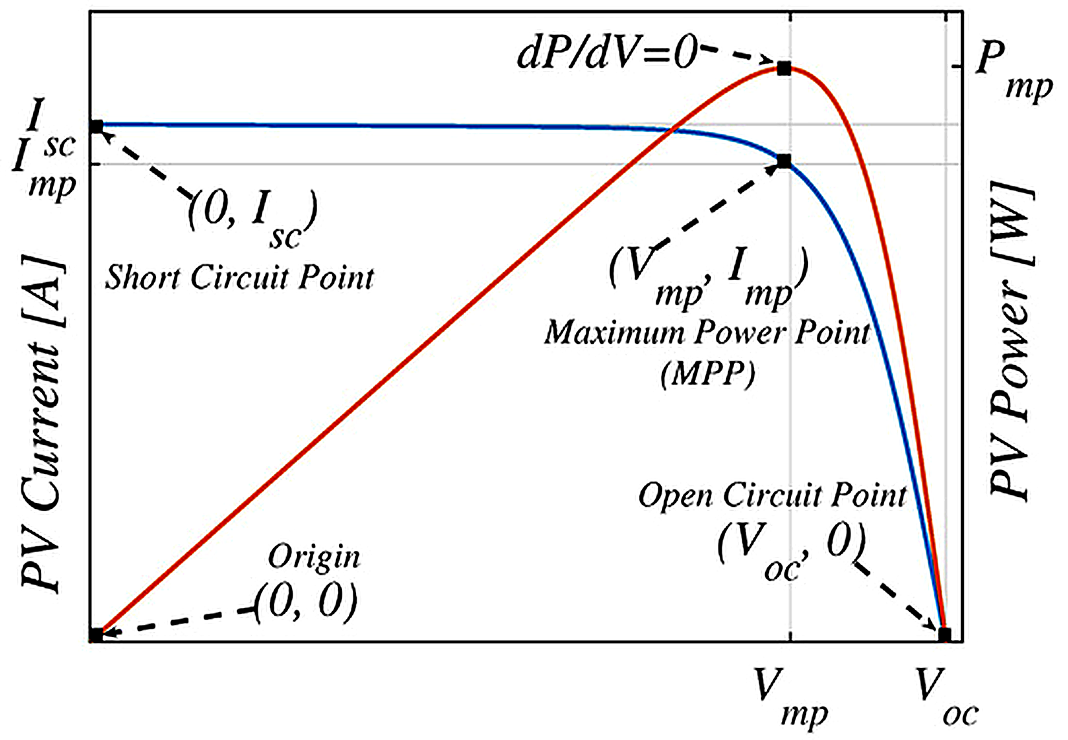
공모전파일/2) 그림파일들/그림 2. 태양전지의 IV 특성 곡선.png
