Appletea404/Solar_Master_Slave/공모전파일/2) 그림파일들/그림 7. Falstad 기반 Buck Converter Circuit.png

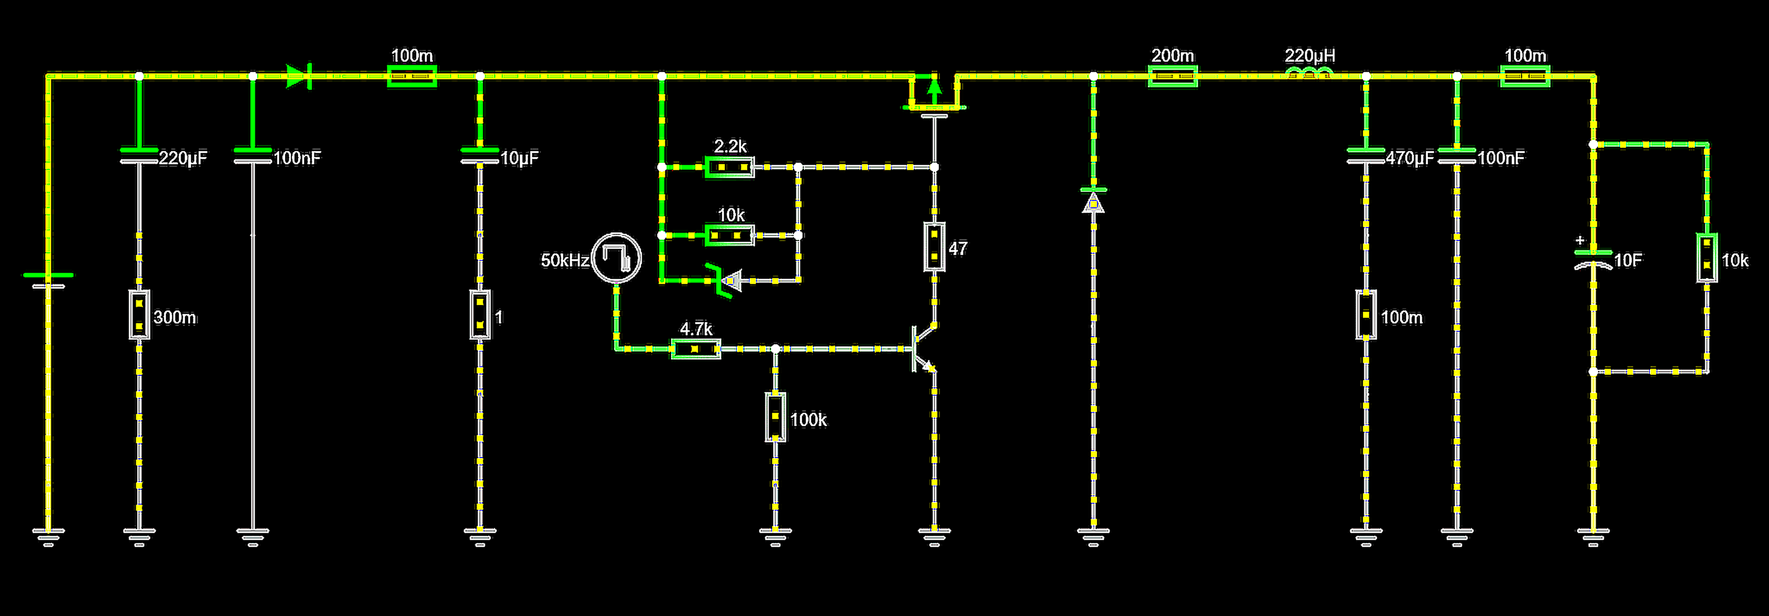
공모전파일/2) 그림파일들/그림 7. Falstad 기반 Buck Converter Circuit.png
