Appletea404/Solar_Master_Slave/공모전파일/2) 그림파일들/그림 8. Solar System Equivalent Model.png

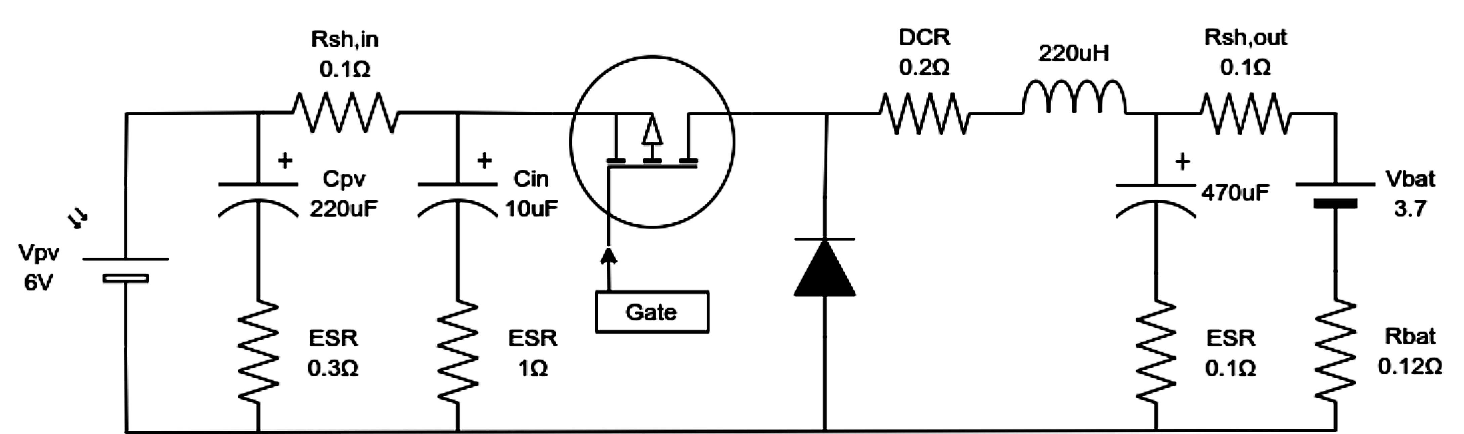
공모전파일/2) 그림파일들/그림 8. Solar System Equivalent Model.png
