Appletea404/Solar_Master_Slave/공모전파일/2) 그림파일들/그림 9. Solar Charge System Equivalent Model (SW ON).png

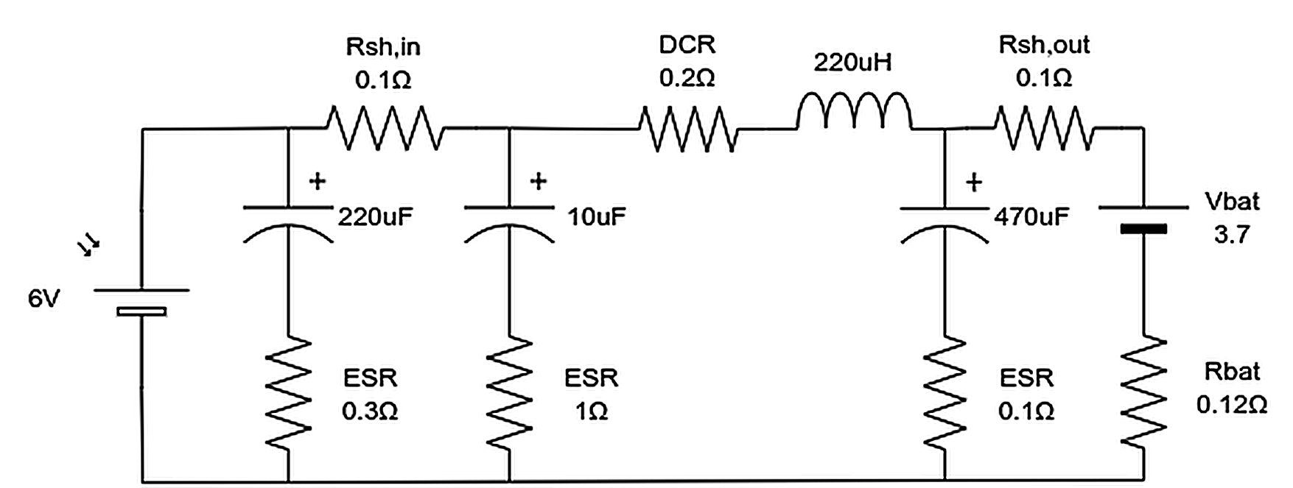
공모전파일/2) 그림파일들/그림 9. Solar Charge System Equivalent Model (SW ON).png
