Appletea404/Solar_Master_Slave/공모전파일/2) 그림파일들/그림 10. Solar Charge System Equivalent Model (SW OFF).png

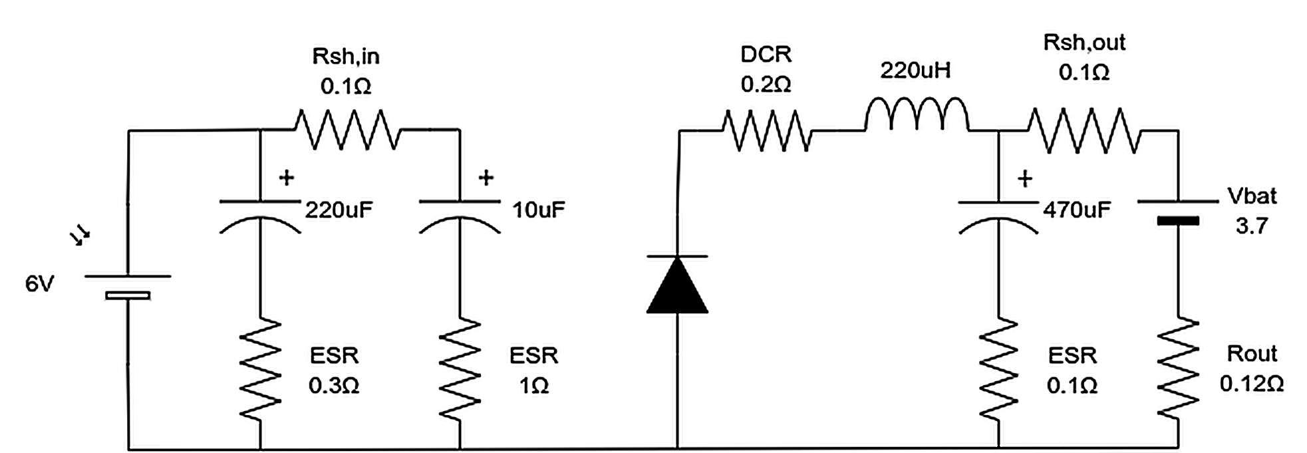
공모전파일/2) 그림파일들/그림 10. Solar Charge System Equivalent Model (SW OFF).png
