Appletea404/Solar_Master_Slave/공모전파일/2) 그림파일들/그림 12. 전압 루프 Bode Plot.png

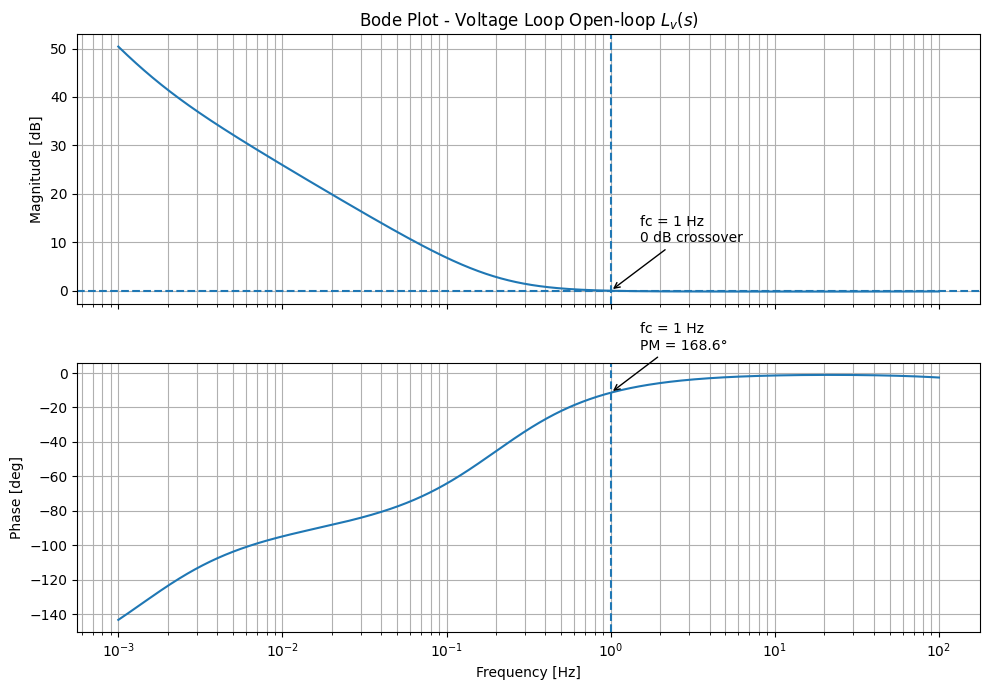
공모전파일/2) 그림파일들/그림 12. 전압 루프 Bode Plot.png
