Appletea404/Solar_Master_Slave/공모전파일/2) 그림파일들/그림 13. Current Limit Selection (CC_CV_MPPT).png

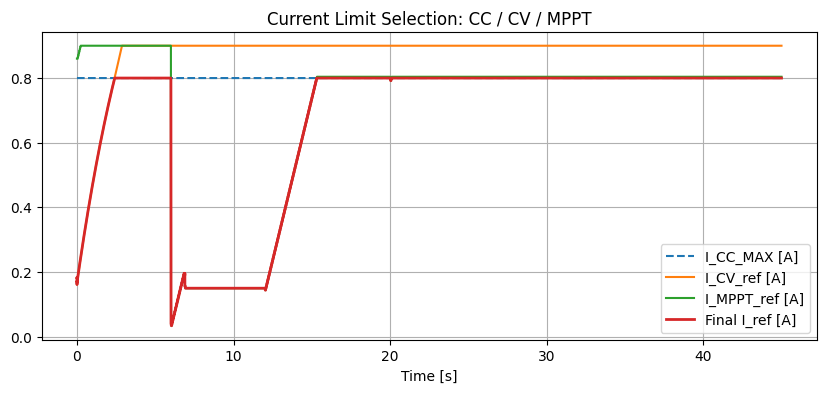
공모전파일/2) 그림파일들/그림 13. Current Limit Selection (CC_CV_MPPT).png
