Appletea404/Solar_Master_Slave/공모전파일/2) 그림파일들/그림 14. Battery Voltage  (CC_CV_MPPT).png

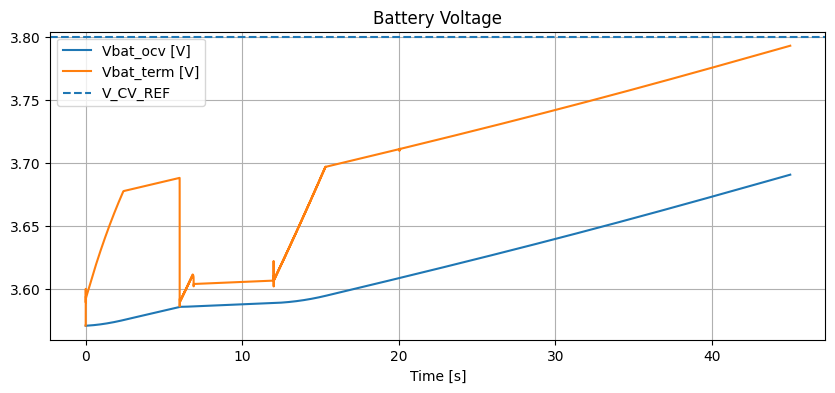
공모전파일/2) 그림파일들/그림 14. Battery Voltage (CC_CV_MPPT).png
