Appletea404/Solar_Master_Slave/공모전파일/2) 그림파일들/그림 16. Solar Charge System FSM.png

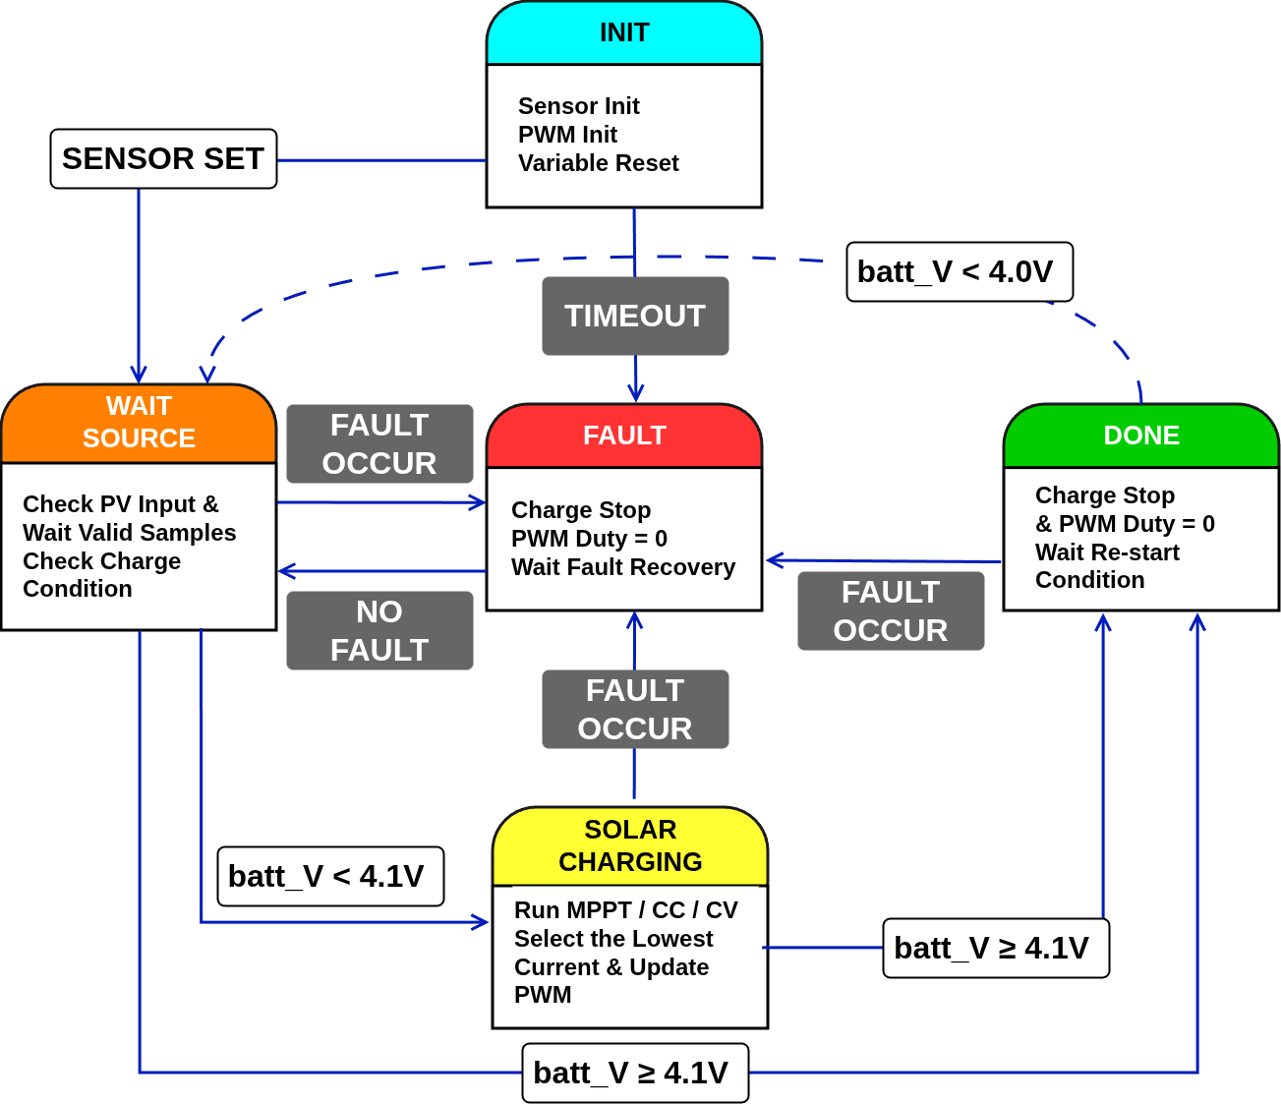
공모전파일/2) 그림파일들/그림 16. Solar Charge System FSM.png
