Appletea404/Solar_Master_Slave/공모전파일/2) 그림파일들/그림 18. Voltage & Current(약 2.9V).png

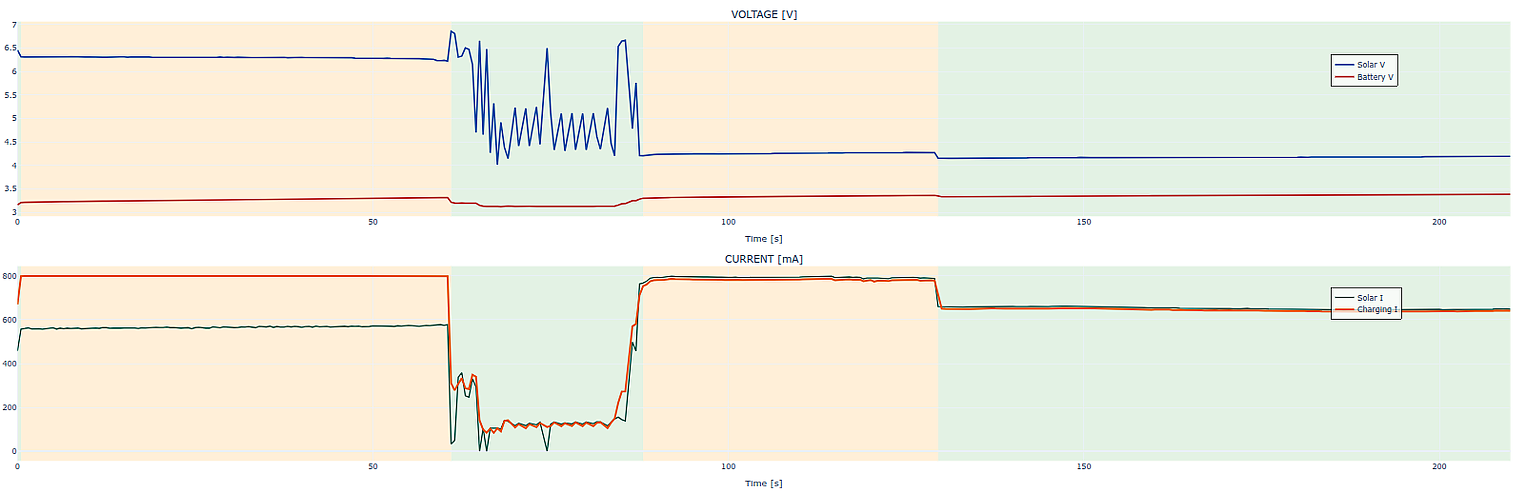
공모전파일/2) 그림파일들/그림 18. Voltage & Current(약 2.9V).png
