Appletea404/Solar_Master_Slave/공모전파일/2) 그림파일들/그림 19. Voltage & Current (약4.1V).png

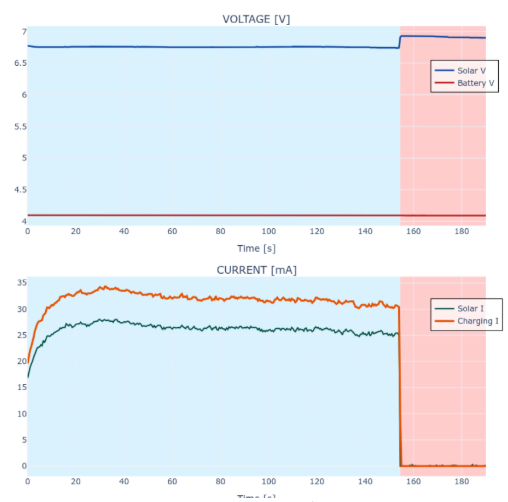
공모전파일/2) 그림파일들/그림 19. Voltage & Current (약4.1V).png
