Appletea404/Solar_Master_Slave/공모전파일/2) 그림파일들/그림 20. Voltage & Current(약 4.2V).png

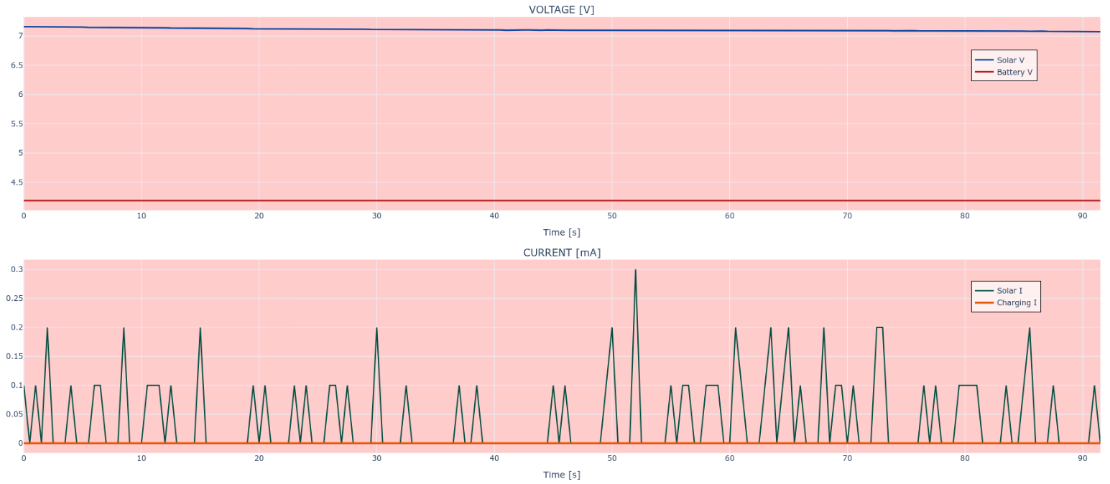
공모전파일/2) 그림파일들/그림 20. Voltage & Current(약 4.2V).png
