Appletea404/Solar_Master_Slave/공모전파일/2) 그림파일들/그림 21. 광원 추적 시스템 HW 블록도.png

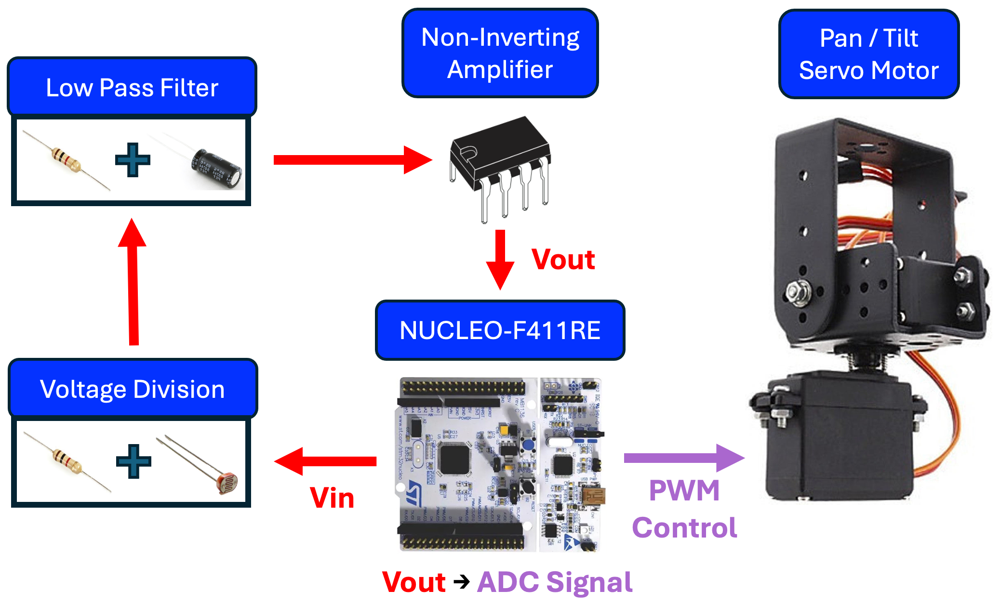
공모전파일/2) 그림파일들/그림 21. 광원 추적 시스템 HW 블록도.png
