Appletea404/Solar_Master_Slave/공모전파일/2) 그림파일들/그림 22. CDS 센서모듈 회로도.png

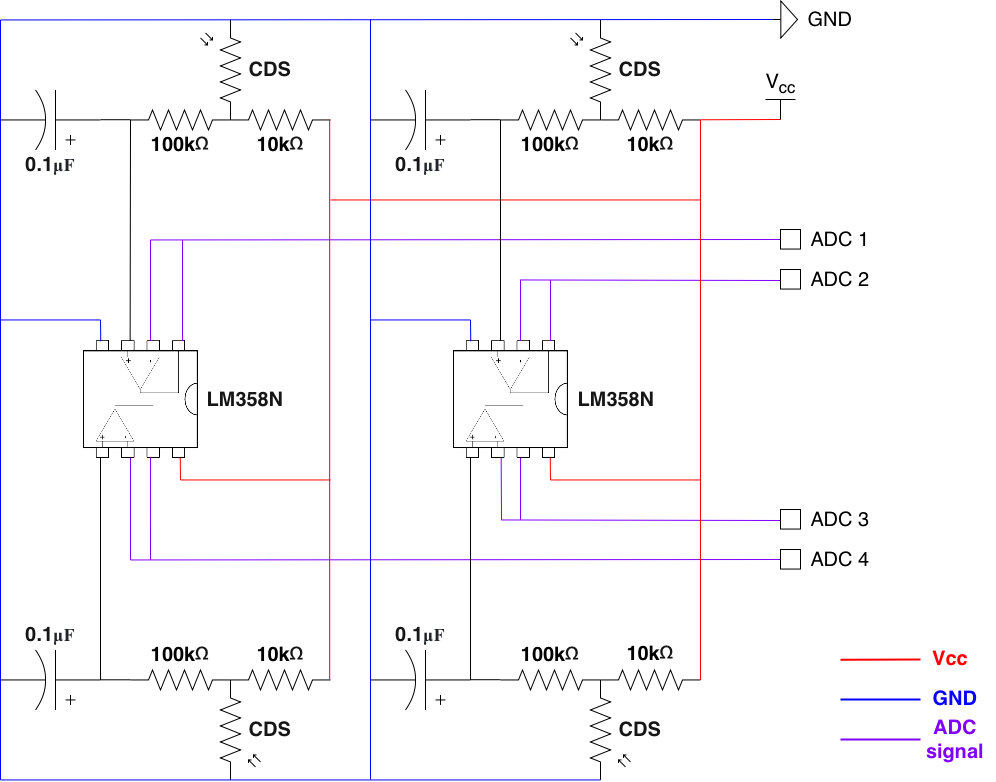
공모전파일/2) 그림파일들/그림 22. CDS 센서모듈 회로도.png
