Appletea404/Solar_Master_Slave/공모전파일/2) 그림파일들/그림 23. 광원 추적 시스템 구동 과정.png

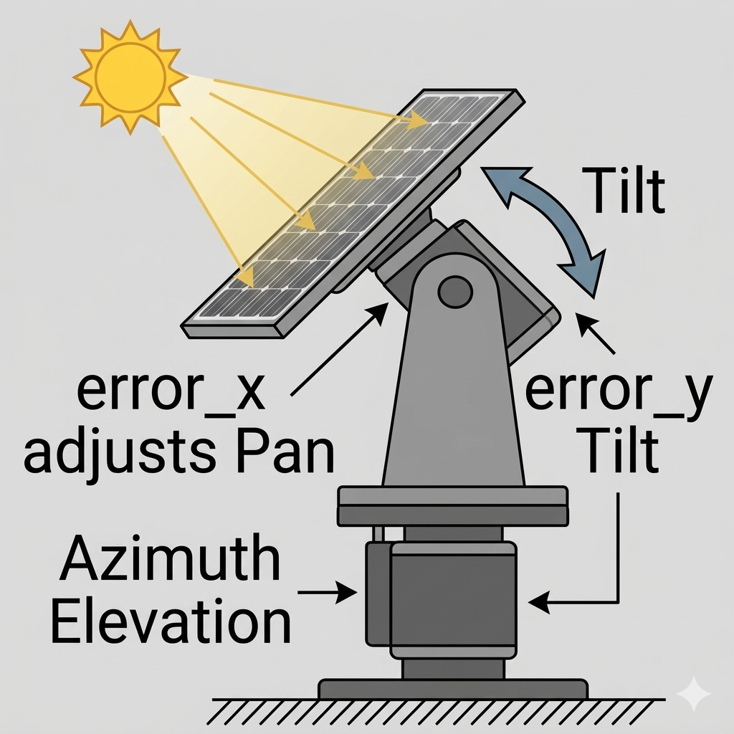
공모전파일/2) 그림파일들/그림 23. 광원 추적 시스템 구동 과정.png
