Appletea404/Solar_Master_Slave/공모전파일/2) 그림파일들/그림 25. 배터리 안전 기능 프로토타입 회로도.png

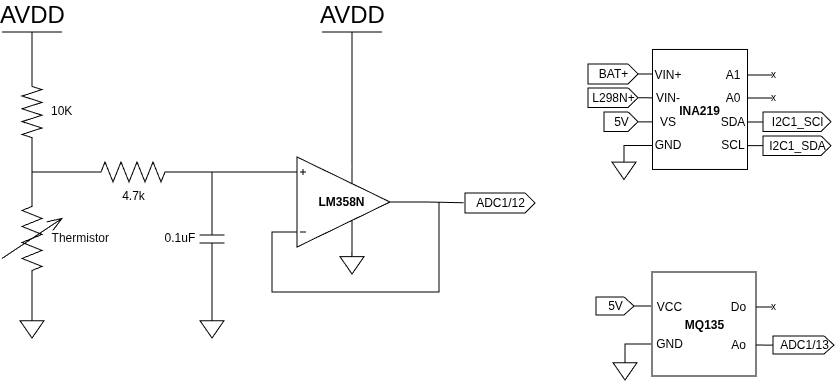
공모전파일/2) 그림파일들/그림 25. 배터리 안전 기능 프로토타입 회로도.png
