Appletea404/Solar_Master_Slave/공모전파일/2) 그림파일들/그림 26. 배터리 안전 기능 프로토타입.jpg

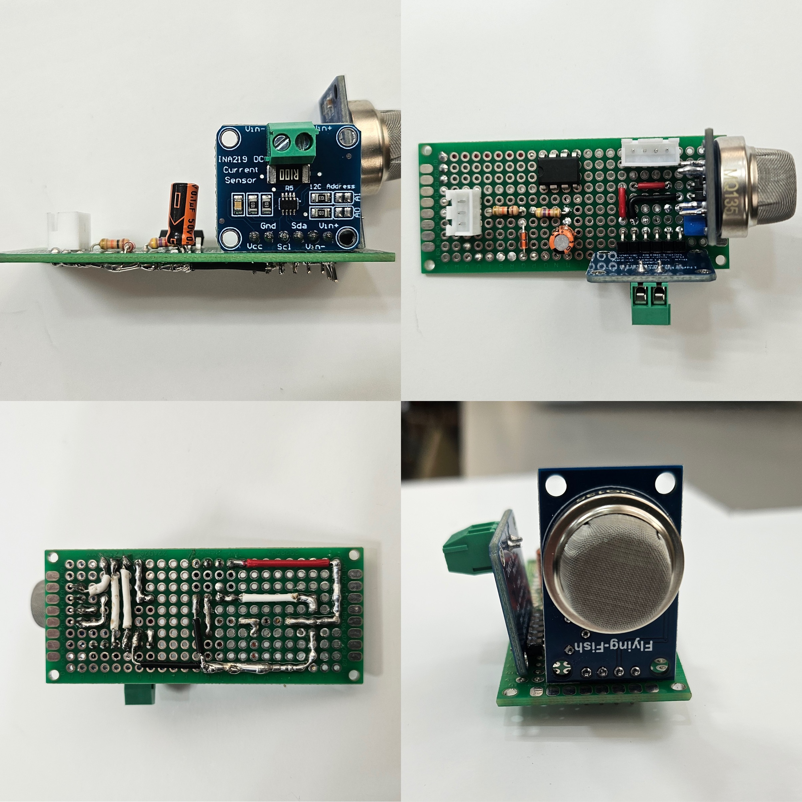
공모전파일/2) 그림파일들/그림 26. 배터리 안전 기능 프로토타입.jpg
