Appletea404/Solar_Master_Slave/공모전파일/2) 그림파일들/그림 28. 자율 주행 FSM.png

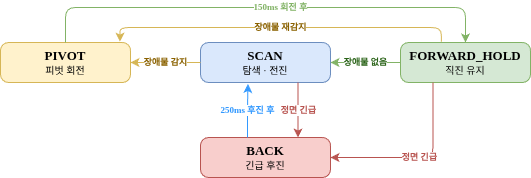
공모전파일/2) 그림파일들/그림 28. 자율 주행 FSM.png
