Appletea404/Solar_Master_Slave/공모전파일/2) 그림파일들/그림 29. STANDARD DATA FRAME (표준 데이터 프레임).png

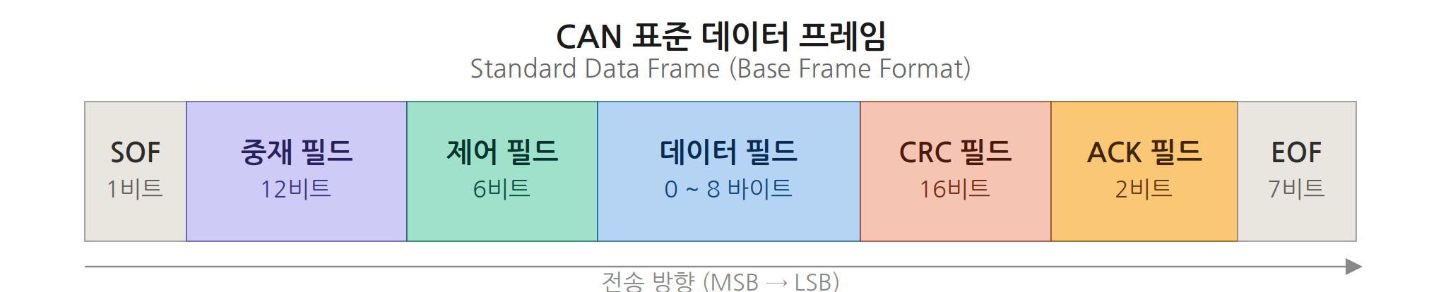
공모전파일/2) 그림파일들/그림 29. STANDARD DATA FRAME (표준 데이터 프레임).png
