Appletea404/Solar_Master_Slave/공모전파일/2) 그림파일들/그림 30. CAN ID 인코딩.png

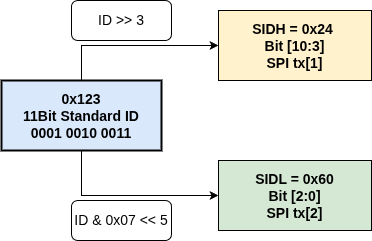
공모전파일/2) 그림파일들/그림 30. CAN ID 인코딩.png
