Appletea404/Solar_Master_Slave/공모전파일/04) 사용한 제품 리스트(BOM).xlsx

Bill of Materials
- | Level Description |  |  |  | Issue Date | 상품명 | 용도 | Revision |  | Writer | 소속
- | 1 | 2 | 3 | 4 | 2026.03.16 | HELIOS-BMS | 광원 추적형 태양광 충전 및 다중 센서 기반 BMS가 결합된 차세대 EV | R01 |  | 박도영 | 경기인력개발원 온디바이스 AI 반도체 설계 2기
NO | Level |  |  |  | 상품번호 | 상품명 | 용도 | 제조사 | 수량 | 단위 | 링크
1 | 1 |  |  |  | - | HELIOS-BMS | 광원 추적형 태양광 충전 및 다중 센서 기반 BMS가 결합된 차세대 EV | 경기인력개발원 | 1 | SET | -
2 |  | 2 |  |  | - | 태양광 충전 시스템 | 광원 추적 기반 태양광 발전 및 충전 시스템 | - | - | - | -
3 |  |  | 3 |  | - | Buck 컨버터 기반 배터리 충전 시스템 | CC/CV/MPPT 기반 Buck 컨버터 충전 제어 | - | - | - | -
4 |  |  |  | 4 | 별도구매 | D165x165-3(6V 4.5W) | 주 충전 전원 공급용 태양전지 패널 | ‎ZJchao | 2 | EA | https://www.amazon.com/Portable-Monocrystalline-Charging-Photovoltaic-165x165MM/dp/B0DPZ1QCZX
5 |  |  |  | 4 | 1338 | E/C 16V 220uF (85℃) | 입력 평활 콘덴서 | SAMYOUNG | 1 | EA | https://www.devicemart.co.kr/goods/view?no=1338
6 |  |  |  | 4 | 1343 | Ceramic 0.1㎌, 50V | 고주파 노이즈 필터 | SAMWON | 2 | EA | https://www.devicemart.co.kr/goods/view?no=1343
7 |  |  |  | 4 | 30 | 1N5822 | 역류방지 및 프리휠링 다이오드 | Any Vender | 2 | EA | https://www.devicemart.co.kr/goods/view?no=30
8 |  |  |  | 4 | 1327562 | SZH-SSBH-075(INA219 High Side DC 전류 센서 모듈) | 태양전지/배터리 전압 및 전류 센싱 | SMG | 2 | EA | https://www.devicemart.co.kr/goods/view?no=1327562
9 |  |  |  | 4 | 1318 | E/C 50V 10uF (85℃) | 입력 보조 평활 | SAMYOUNG | 1 | EA | https://www.devicemart.co.kr/goods/view?no=1318
10 |  |  |  | 4 | 11781 | IRF9540N | 벅 컨버터 주 스위칭 소자(PMOS) | IR | 1 | EA | https://www.devicemart.co.kr/goods/view?no=11781
11 |  |  |  | 4 | 15820277 | ada-2782(2.2K ohm 5% 1/4W) | 게이트 바이어스 저항 | Adafruit | 1 | EA | https://www.devicemart.co.kr/goods/view?no=15820277
12 |  |  |  | 4 | 15820276 | ada-2784(10K ohm 5% 1/4W) | 게이트 바이어스 저항 | Adafruit | 1 | EA | https://www.devicemart.co.kr/goods/view?no=15820276
13 |  |  |  | 4 | 3058 | 1N4740A-10V | 게이트 보호용 제너 다이오드 | HORNBY | 2 | EA | https://www.devicemart.co.kr/goods/view?no=3058
14 |  |  |  | 4 | 1988 | 1/4W 1% Axial Resistor 470F (47Ω) | 게이트 링잉 억제 저항 | 제일전자 | 1 | EA | https://www.devicemart.co.kr/goods/view?no=1988
15 |  |  |  | 4 | 3247 | 2N2222A(MPS) | 게이트 구동용 NPN 트렌지스터 | Any Vendor | 1 | EA | https://www.devicemart.co.kr/goods/view?no=3247
16 |  |  |  | 4 | 15820279 | ada-2783(4.7K ohm 5% 1/4W) | 베이스 전류 제한 저항 | Adafruit | 1 | EA | https://www.devicemart.co.kr/goods/view?no=15820279
17 |  |  |  | 4 | 15820275 | ada-2787(100K ohm 5% 1/4W) | 베이스 풀다운 저항 | Adafruit | 1 | EA | https://www.devicemart.co.kr/goods/view?no=15820275
18 |  |  |  | 4 | 15691 | RING COIL 11파이(220uH) | Buck 컨버터 에너지 저장 인덕터 | 서광전자 | 1 | EA | https://www.devicemart.co.kr/goods/view?no=15691
19 |  |  |  | 4 | 4085 | E/C 16V 470uF (105℃) | 출력 평활 콘덴서 | SAMYOUNG | 1 | EA | https://www.devicemart.co.kr/goods/view?no=4085
20 |  |  |  | 4 | 12486582 | UB848(18650 리튬이온 배터리 3.7V 2600mAh) | 충전 에너지 저장용 리튬이온 배터리 | Coms | 1 | EA | https://www.devicemart.co.kr/goods/view?no=12486582
21 |  |  |  | 4 | 1278220 | SZH-EK010(HC-06 블루투스 모듈) | 태양광 충전 상태 모니터링 | OEM | 1 | EA | https://www.devicemart.co.kr/goods/view?no=1278220
22 |  |  | 3 |  | - | 광원 추적 시스템 | 조도 센서 기반 광원 추적 제어 | - | - | - | -
23 |  |  |  | 4 | 별도구매 | SRS-155(3V 150mA) | 조도 기반 광원 추적부 태양전지 패널 | 사이언쌤 | 4 | EA | https://www.srs7909.co.kr/eshop/view.html?skin=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
24 |  |  |  | 4 | 15237959 | LM2596HV Buck Converter Module | 서보모터 구동 전원 강압용 Buck Converter | 태진기술 | 1 | EA | https://www.devicemart.co.kr/goods/view?no=15237959
25 |  |  |  | 4 | 12486582 | UB848(18650 리튬이온 배터리 3.7V 2600mAh) | 서보모터 구동 전원 | Coms | 1 | EA | https://www.devicemart.co.kr/goods/view?no=12486582
26 |  |  |  | 4 | 1313388 | TowerPro 호환 서보모터 MG996R | 서보모터_태양광 패널 방향 구동 | SMG | 2 | EA | https://www.devicemart.co.kr/goods/view?no=1313388
27 |  |  |  | 4 | 15871 | CdS Cell (GL5549) | 조도센서_광원 방향 검출 | NTS | 4 | EA | https://www.devicemart.co.kr/goods/view?no=15871
28 |  |  |  | 4 | 1056895 | LM358N | 조도센서 신호 비반전 증폭 |  | 2 | EA | https://www.devicemart.co.kr/goods/view?no=1056895
29 |  |  |  | 4 | 15820276 | ada-2784(10K ohm 5% 1/4W) | 조도센서 신호 기준 형성용 풀업 저항 | Adafruit | 4 | EA | https://www.devicemart.co.kr/goods/view?no=15820276
30 |  |  |  | 4 | 15820275 | ada-2787(100K ohm 5% 1/4W) | 조도센서 노이즈 저감용 저역통과필터 저항 | Adafruit | 4 | EA | https://www.devicemart.co.kr/goods/view?no=15820275
31 |  |  |  | 4 | 별도구매 | 0.1uF 50v Electrolytic Capacitor | 조도센서 노이즈 저감용 저역통과필터 커패시터 | Rubycon | 4 | EA | https://www.digikey.kr/ko/products/detail/rubycon/50YK0R1M5X11/6182869
32 |  | 2 |  |  | - | 배터리 안전 관리 시스템 | 온도, 가스, 과전류 이상 감지 시스템 | - | - | -
33 |  |  | 3 |  | - | 온도 감지 시스템 | 배터리 및 시스템 온도 모니터링 | - | - | -
34 |  |  |  | 4 | 9494 | NTC-10KGJG | 온도 감지용 서미스터 센서 | THERMOMETRICS | 1 | EA | https://www.devicemart.co.kr/goods/view?no=9494
35 |  |  |  | 4 | 1056895 | LM358N | 온도센서 신호 비반전 증폭 |  | 1 | EA | https://www.devicemart.co.kr/goods/view?no=1056895
36 |  |  |  | 4 | 15820276 | ada-2784(10K ohm 5% 1/4W) | 센서 신호 기준 형성용 풀업 저항 | Adafruit | 1 | EA | https://www.devicemart.co.kr/goods/view?no=15820276
37 |  |  |  | 4 | 15820279 | ada-2783(4.7K ohm 5% 1/4W) | 센서 노이즈 저감용 저역통과필터 저항 | Adafruit | 1 | EA | https://www.devicemart.co.kr/goods/view?no=15820279
38 |  |  |  | 4 | 별도구매 | 0.1uF 50v Electrolytic Capacitor | 센서 노이즈 저감용 저역통과필터 커패시터 | Rubycon | 1 | EA | https://www.digikey.kr/ko/products/detail/rubycon/50YK0R1M5X11/6182869
39 |  |  | 3 |  |  | 가스 감지 시스템 | 유해가스 및 공기질 이상 감지
40 |  |  |  | 4 | 1327411 | SZH-SSBH-038(MQ-135 아두이노 유해가스/공기질 센서 모듈) | 유해가스 및 공기질 이상 모니터링 | SMG | 1 | EA | https://www.devicemart.co.kr/goods/view?no=1327411
41 |  |  | 3 |  |  | 과전류 감지 시스템 | 차량 구동 전류 이상 감지
42 |  |  |  | 4 | 1327562 | SZH-SSBH-075(INA219 High Side DC 전류 센서 모듈) | 차량 구동 모터 전류 측정 및 과전류 이상 모니터링 | SMG | 1 | EA | https://www.devicemart.co.kr/goods/view?no=1327562
43 |  | 2 |  |  |  | 차량 주행 제어 시스템 | 차량 주행 제어(수동/자동 모드) | - | - | -
44 |  |  | 3 |  |  | 차량 본체 및 구동부 | 차량 본체 및 구동부 제어 | - | - | -
45 |  |  |  | 4 | 1327455 | SZH-EK098 | 4WD 차량 프레임 및 구동 플랫폼 | SMG | 1 | SET | https://www.devicemart.co.kr/goods/view?no=1327455
46 |  |  |  | 4 | 1361833 | NUCLEO-F411RE | 제어 메인보드 | STMicroelectronics | 1 | EA | https://www.devicemart.co.kr/goods/view?no=1361833
47 |  |  |  | 4 | 1278835 | SZH-EK001(2A L298 모터드라이버 모듈) | 좌, 우 DC 모터 구동 제어 | SMG | 1 | EA | https://www.devicemart.co.kr/goods/view?no=1278835
48 |  |  |  | 4 | 1323062 | SZH-USBC-004(초음파 거리센서 모듈) | 장애물 거리 측정 | SMG-A | 3 | EA | https://www.devicemart.co.kr/goods/view?no=1323062
49 |  |  |  | 4 | 12486582 | UB848(18650 리튬이온 배터리 3.7V 2600mAh) | 차량 구동 전원 | Coms | 3 | EA | https://www.devicemart.co.kr/goods/view?no=12486582
50 |  |  |  | 4 | 1278220 | SZH-EK010(HC-06 블루투스 모듈) | 배터리 안전 관리 시스템 모니터링 | OEM | 1 | EA | https://www.devicemart.co.kr/goods/view?no=1278220
51 |  |  |  | 4 | 1289993 | SZH-EK069(HC-05 블루투스 모듈) | 차량 측 블루투스 송신 통신(Slave) | SMG | 1 | EA | https://www.devicemart.co.kr/goods/view?no=1289993
52 |  |  |  | 4 | 15883488 | MCP2515 CAN BUS TJA1050 수신기 [VLT-CAN001] | SPI통신을 통해 STM32와 통신 및 CAN 모듈끼리 통신 | EM Tech | 2 | EA | https://www.devicemart.co.kr/goods/view?no=15883488
53 |  |  | 3 |  |  | 무선 조종부 | 무선 조종 제어 | - | - | -
54 |  |  |  | 4 | 14997708 | ada-4877(STM32F411 'BlackPill' Development Board) | 조종기 입력 처리 및 무선 송신 제어 | Adafruit | 1 | EA | https://www.devicemart.co.kr/goods/view?no=14997708
55 |  |  |  | 4 | 1384041 | ELB070682(PS2 조이스틱 듀얼 로커 버튼 모듈) | 조종 입력 및 광원 추적 제어 입력 | YwRobot | 1 | EA | https://www.devicemart.co.kr/goods/view?no=1384041
56 |  |  |  | 4 | 1289993 | SZH-EK069(HC-05 블루투스 모듈) | 조종기 측 블루투스 송신 통신(Master) | SMG | 1 | EA | https://www.devicemart.co.kr/goods/view?no=1289993
57 |  |  |  | 4 | 12486582 | UB848(18650 리튬이온 배터리 3.7V 2600mAh) | 조종기 전원 | Coms | 1 | EA | https://www.devicemart.co.kr/goods/view?no=12486582
