Appletea404/Solar_Master_Slave/공모전파일/2) 그림파일들/그림 17. Charging Characteristics (약 3.7V).png

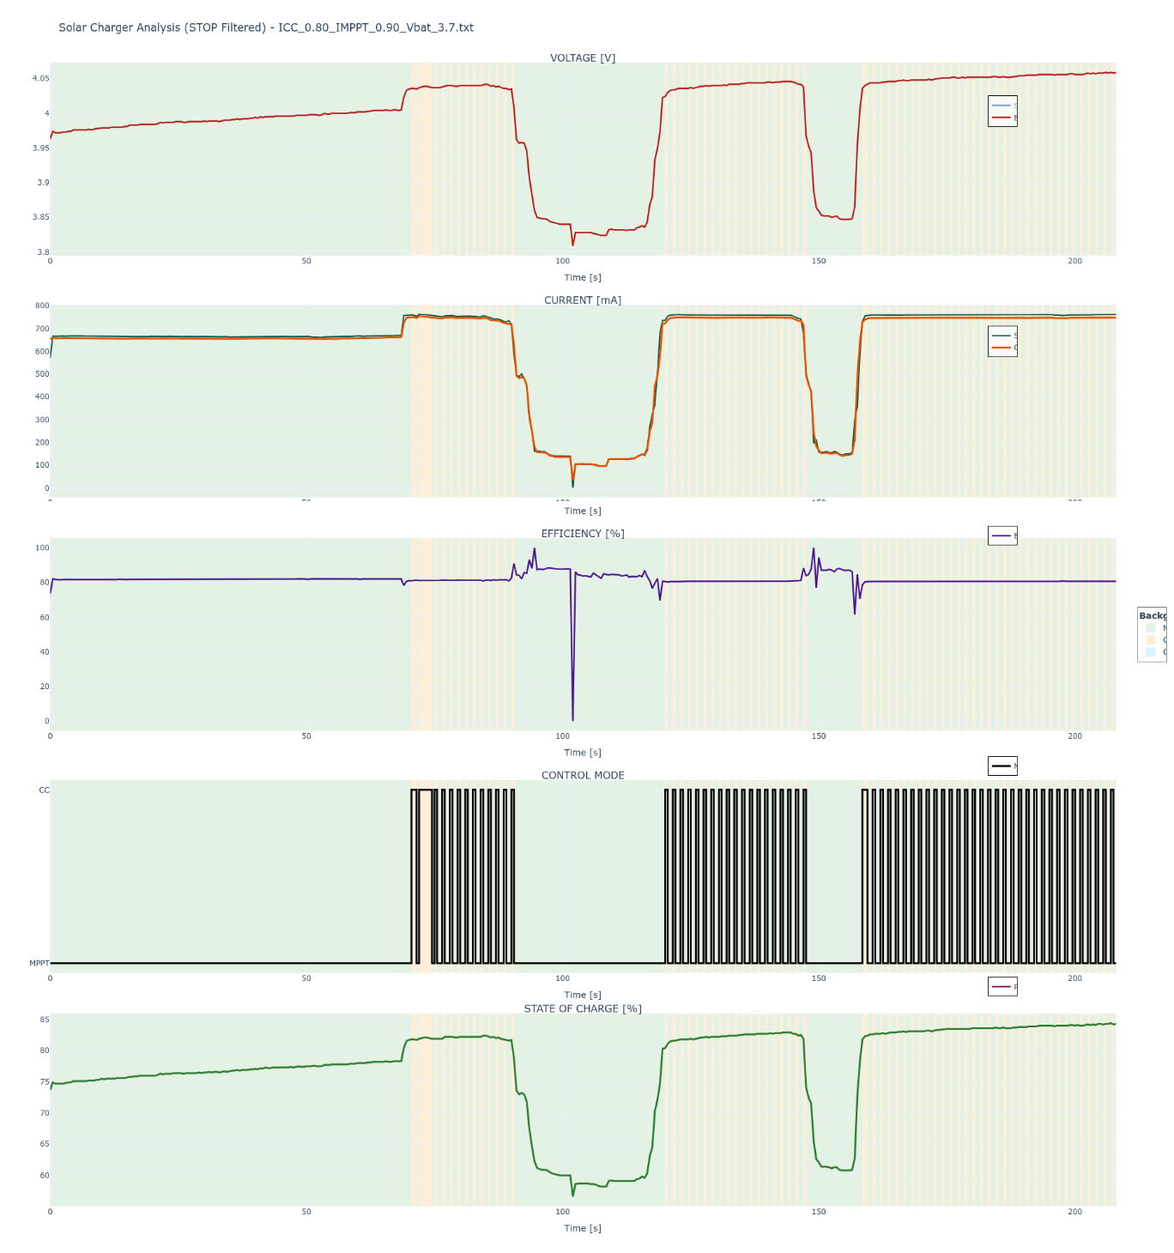
공모전파일/2) 그림파일들/그림 17. Charging Characteristics (약 3.7V).png
