Appletea404/Solar_Master_Slave/Solar_master_R01/Core/Src/main.c

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
/* Includes ------------------------------------------------------------------*/
#include "main.h"
#include "adc.h"
#include "dma.h"
#include "i2c.h"
#include "spi.h"
#include "tim.h"
#include "usart.h"
#include "gpio.h"

/* USER CODE BEGIN Includes */



// CAR
#include "car.h"
#include "direction.h"
#include "speed.h"
#include "delay.h"
#include "stdio.h"
#include "ultrasonic.h"
#include "statemachine.h"


// BMS
#include "bms_temp.h"
#include "bms_gas.h"
#include "bms_ina219.h"
#include "bms_message.h"


#include "app_bms.h"

// SPI
#include "can.h"



#include <stdio.h>


/* USER CODE END Includes */


/* USER CODE BEGIN PV */


volatile uint16_t adcValue[2] = {0U, 0U};


/* USER CODE END PV */

void SystemClock_Config(void);
/* USER CODE BEGIN 0 */


/* =========================================================
 * HAL callback forwarding (SPI / GPIO / TIM)
 * ========================================================= */
void HAL_SPI_TxRxCpltCallback(SPI_HandleTypeDef *hspi)
{
    Can_SpiTxRxCpltCallback(hspi);
}

void HAL_SPI_ErrorCallback(SPI_HandleTypeDef *hspi)
{
    Can_SpiErrorCallback(hspi);
}

void HAL_GPIO_EXTI_Callback(uint16_t GPIO_Pin)
{
    Can_ExtiCallback(GPIO_Pin);
}

void HAL_TIM_PeriodElapsedCallback(TIM_HandleTypeDef *htim)
{
    if (htim->Instance == TIM11)
    {
        /* 필요 시 하위 모듈 tick 연결 */
    }
}

/* =========================================================
 * UART RX complete
 * ---------------------------------------------------------
 * UART1 : 기존 리모컨 / statemachine 경로
 * UART2 : moserial 입력 테스트 경로 (현재 비활성)
 * ========================================================= */
void HAL_UART_RxCpltCallback(UART_HandleTypeDef *huart)
{
    if (huart == NULL)
    {
        return;
    }

    /* UART1 기존 리모컨 경로 */
    STMACHINE_UartRxCpltCallback(huart);

}


void HAL_UART_TxCpltCallback(UART_HandleTypeDef *huart)
{
    BMS_MESSAGE_UartTxCpltCallback(huart);

    /* 다른 UART DMA 완료 처리 있으면 여기 계속 추가 */
}

void HAL_UART_ErrorCallback(UART_HandleTypeDef *huart)
{
    BMS_MESSAGE_UartErrorCallback(huart);

    /* 다른 UART 에러 처리 있으면 여기 계속 추가 */
}

void HAL_I2C_MemRxCpltCallback(I2C_HandleTypeDef *hi2c)
{
    INA219_BMS_I2C_MemRxCpltCallback(hi2c);
}

void HAL_I2C_MemTxCpltCallback(I2C_HandleTypeDef *hi2c)
{
    INA219_BMS_I2C_MemTxCpltCallback(hi2c);
}

void HAL_I2C_ErrorCallback(I2C_HandleTypeDef *hi2c)
{
    INA219_BMS_I2C_ErrorCallback(hi2c);
}




/* USER CODE END 0 */

/**
  * @brief  The application entry point.
  * @retval int
  */
int main(void)
{

  /* MCU Configuration--------------------------------------------------------*/

  /* Reset of all peripherals, Initializes the Flash interface and the Systick. */
  HAL_Init();

  /* Configure the system clock */
  SystemClock_Config();

  /* Initialize all configured peripherals */
  MX_GPIO_Init();
  MX_DMA_Init();
  MX_USART1_UART_Init();
  MX_TIM2_Init();
  MX_TIM3_Init();
  MX_TIM11_Init();
  MX_ADC1_Init();
  MX_I2C1_Init();
  MX_USART6_UART_Init();
  MX_SPI1_Init();
  /* USER CODE BEGIN 2 */


  /* ADC DMA는 app_bms init 전에 먼저 시작 */
  if (HAL_ADC_Start_DMA(&hadc1, (uint32_t *)adcValue, 2) != HAL_OK)
  {
      Error_Handler();
  }

  /* 기존 코드에서 TIM11 base start를 쓰고 있으니 일단 유지 */
  if (HAL_TIM_Base_Start(&htim11) != HAL_OK)
  {
      Error_Handler();
  }

  /* 상위 통합 app 초기화 */
  App_Bms_Init();






  Can_Init();






  /* USER CODE END 2 */

  /* Infinite loop */
  /* USER CODE BEGIN WHILE */
  while (1)
  {


	  App_Bms_Task();

    /* USER CODE END WHILE */

    /* USER CODE BEGIN 3 */
  }
  /* USER CODE END 3 */
}

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
