Appletea404/Solar_Master_Slave/(commit log)

2026-03-25 Solar_charge_toggle failure / unable Force system
    [main.c]
2026-03-25 Address all issues except Ultrasonic
2026-04-12 Files add
    [04) 사용한 제품 리스트(BOM).xlsx]
