Appletea404/Solar_Master_Slave/(notices)

Notices in the files:
Solar_master_R01/Core/Src/main.c:
Copyright (c) 2026 STMicroelectronics.
All rights reserved.
This software is licensed under terms that can be found in the LICENSE file
